Polati1/new-tracker-hardware/NewTrackerMotor/Stackup_Impedance.png

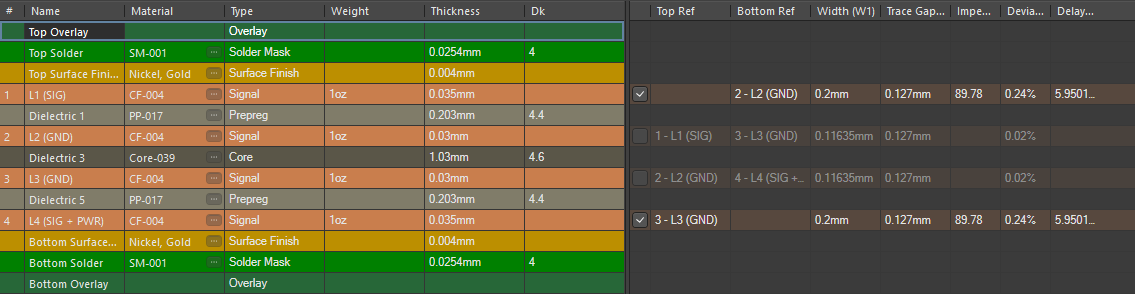
NewTrackerMotor/Stackup_Impedance.png
