Polati1/new-tracker-hardware/README.md

Schematics / PCBs / BOM / Gerber Files / Libraries / Footprints of:

1. FLO Motor Driver Control Board
2. FLO Orientation Sensing Board
3. FLO Stepper Driver Control Board
4. FLO IR Illumination Control Board
5. FLO IR Illumination LED Board
6. Additional Buck Converter Layouts
