Polati1/new-tracker-hardware/NewTrackerIR/NewTrackerIR.pdf

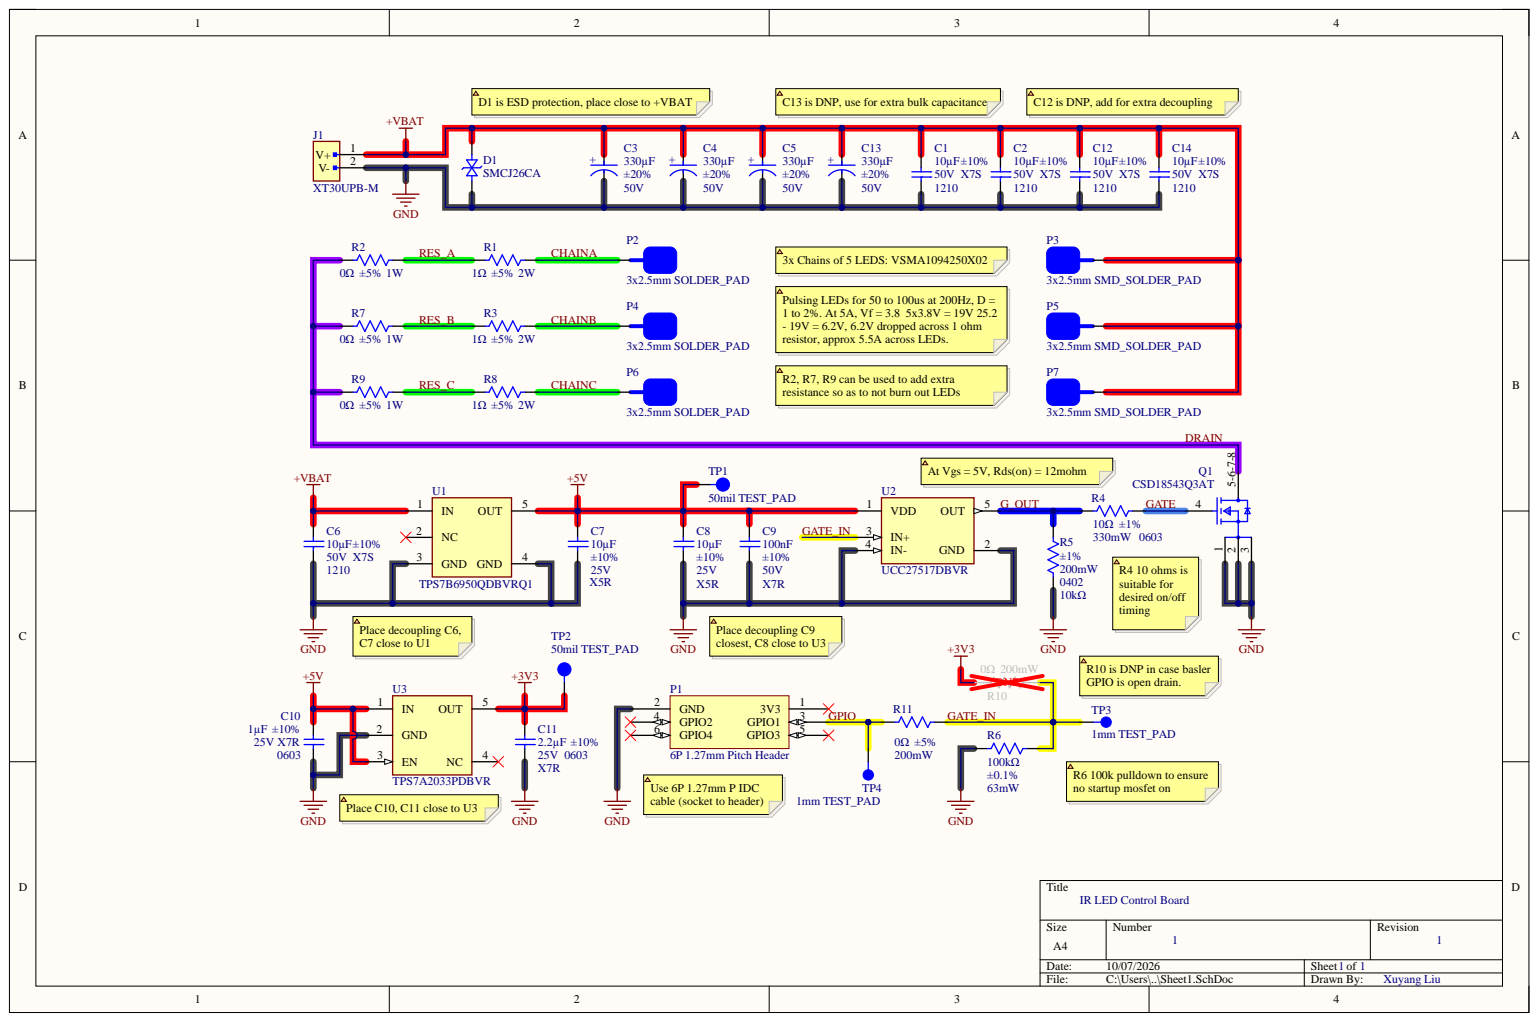
[picture p2: page 1]

Pulsing LEDs for 50 to 100us at 200Hz, D =
- 19V = 6.2V, 6.2V dropped across 1 ohm
resistor, approx 5.5A across LEDs.

R2, R7, R9 can be used to add extra
resistance so as to not burn out LEDs

At Vgs = 5V, Rds(on) = 12mohm

R10 is DNP in case basler
GPIO is open drain.

GND 2

R6 100k pulldown to ensure
no startup mosfet on

Use 6P 1.27mm P IDC
cable (socket to header)

IR LED Control Board

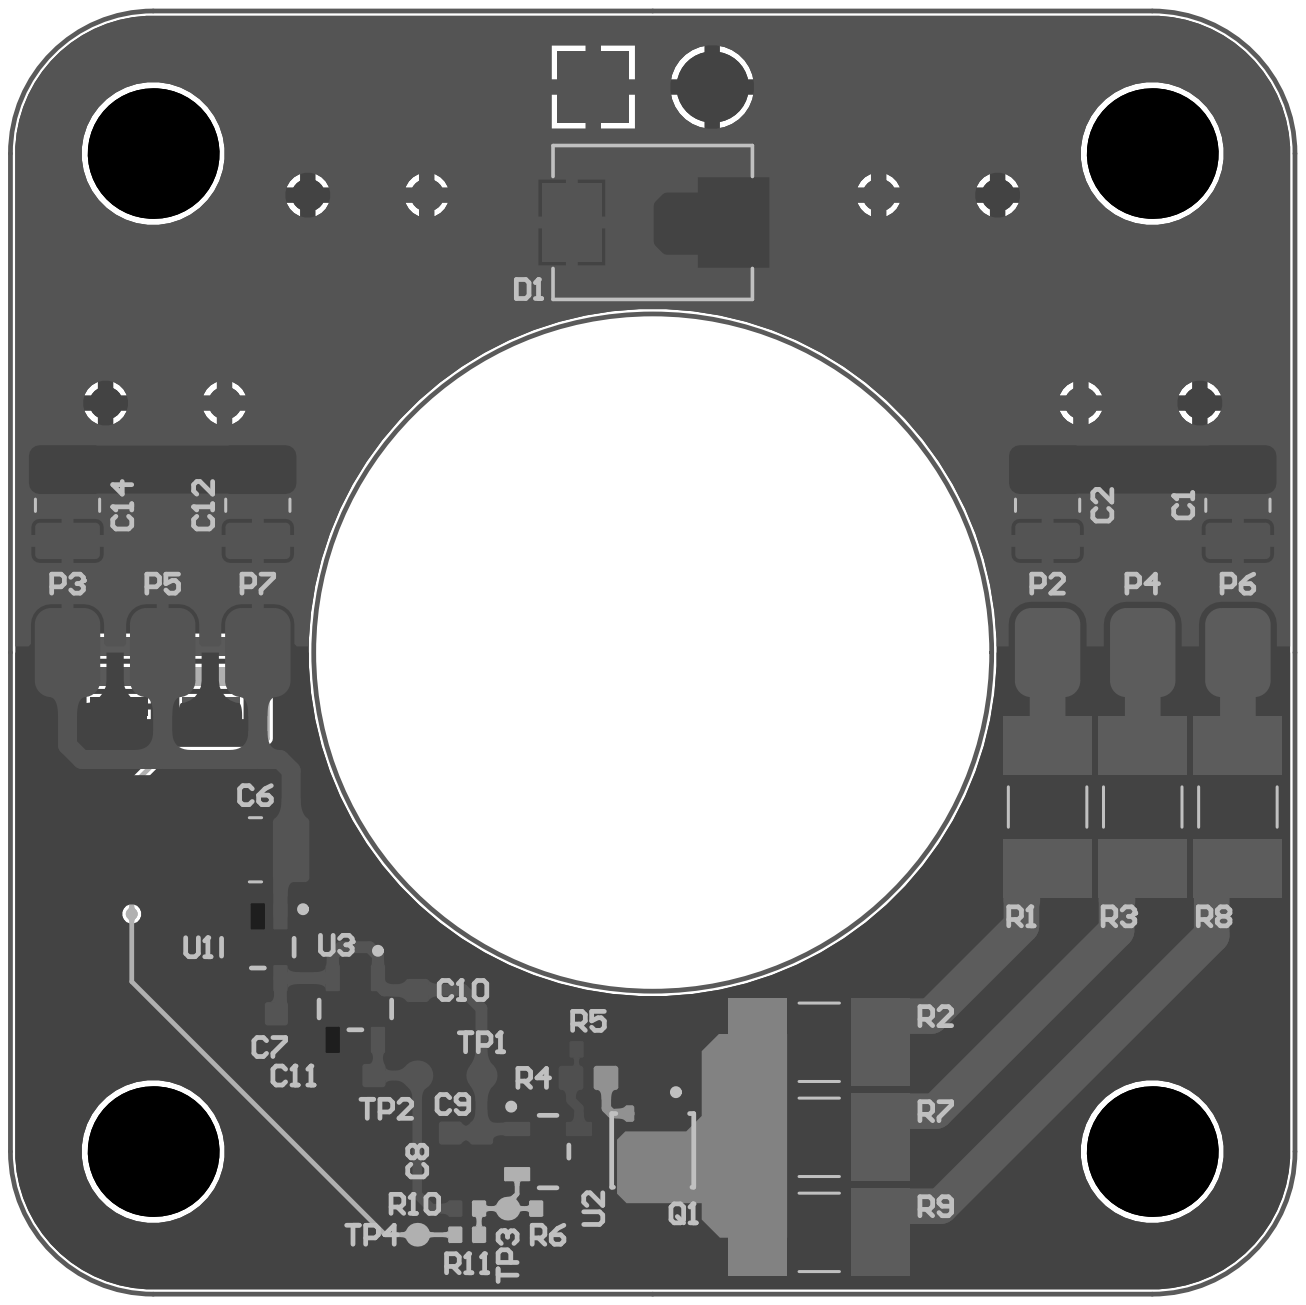
[picture p3: page 2]
