Polati1/new-tracker-hardware/NewTrackerMain/NewTrackerMain.pdf

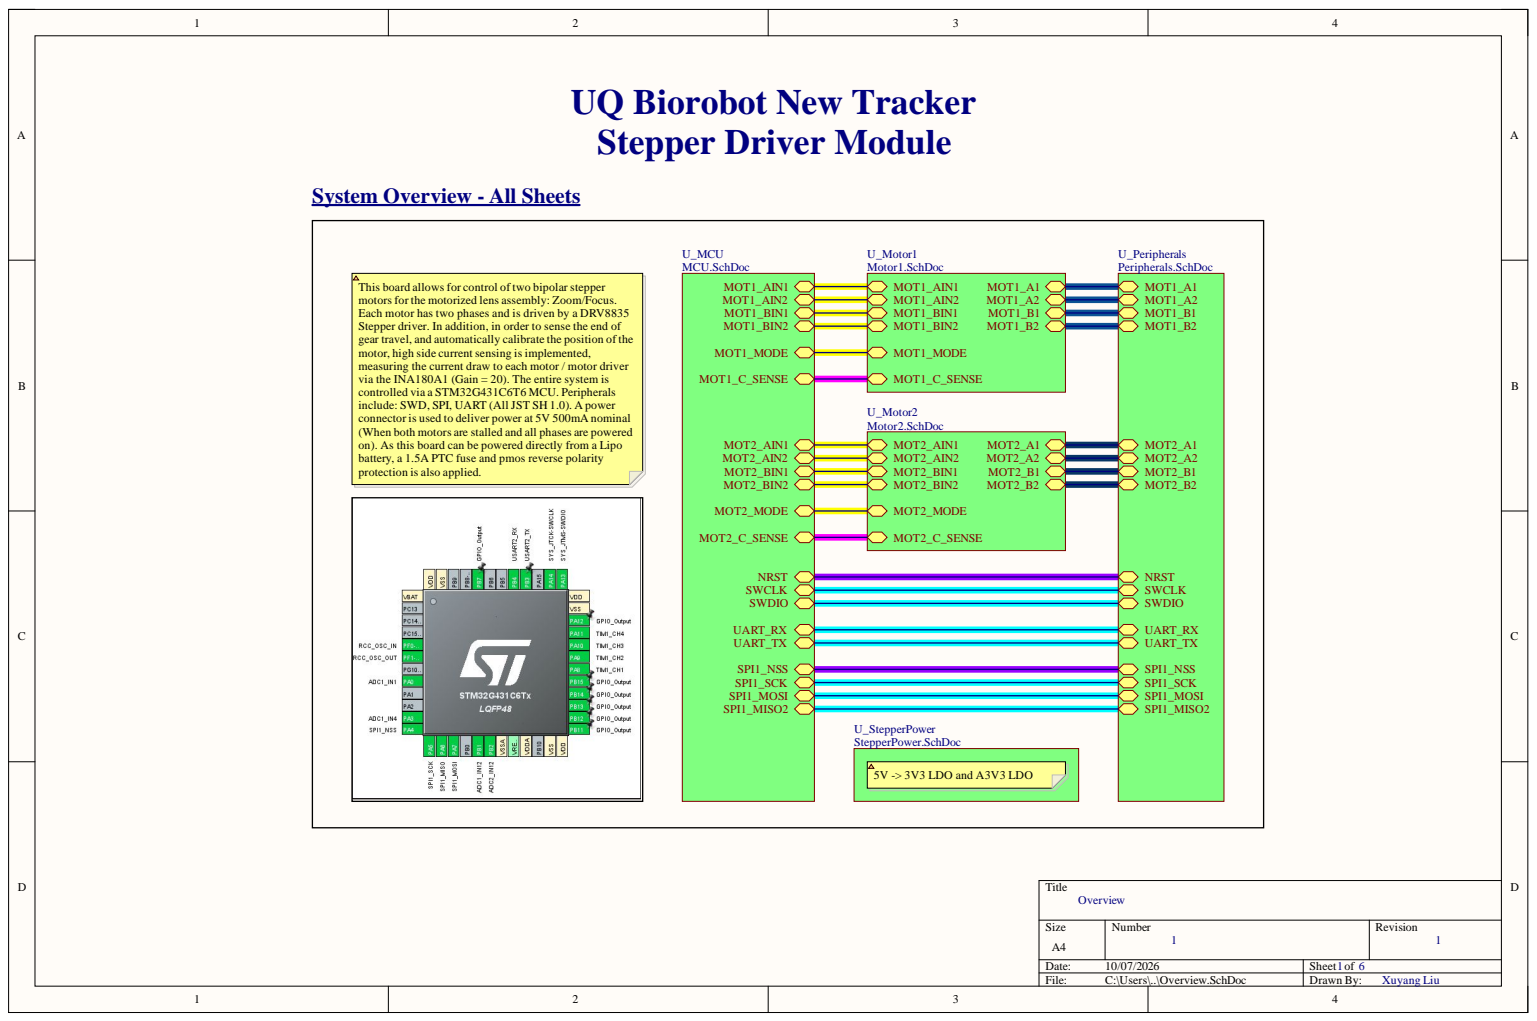
[picture p4: page 1]

UQ Biorobot New Tracker
Stepper Driver Module

System Overview - All Sheets

This board allows for control of two bipolar stepper
motors for the motorized lens assembly: Zoom/Focus.
Each motor has two phases and is driven by a DRV8835
Stepper driver. In addition, in order to sense the end of
gear travel, and automatically calibrate the position of the
motor, high side current sensing is implemented,
measuring the current draw to each motor / motor driver
via the INA180A1 (Gain = 20). The entire system is
controlled via a STM32G431C6T6 MCU. Peripherals
include: SWD, SPI, UART (All JST SH 1.0). A power
connector is used to deliver power at 5V 500mA nominal
(When both motors are stalled and all phases are powered
on). As this board can be powered directly from a Lipo
battery, a 1.5A PTC fuse and pmos reverse polarity
protection is also applied.

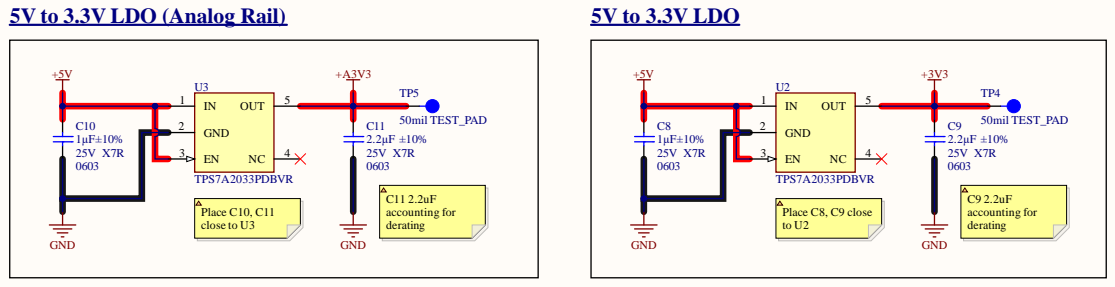
[picture p5: page 2]

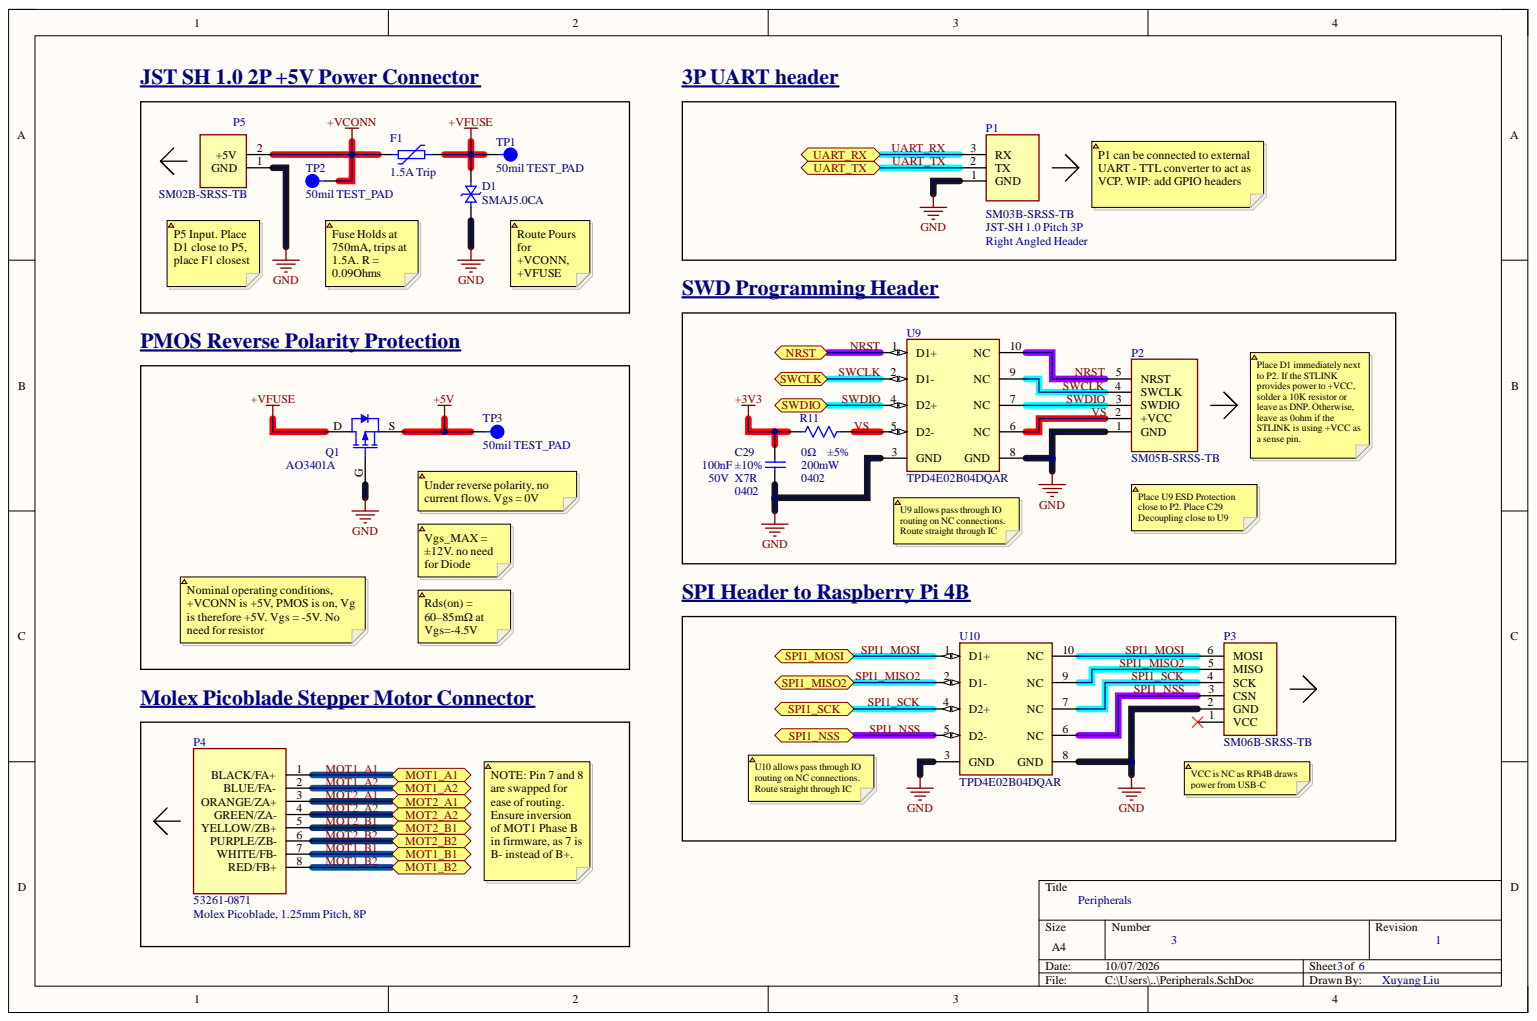
[picture p6: page 3]

JST SH 1.0 2P +5V Power Connector

P1 can be connected to external
UART - TTL converter to act as
VCP. WIP: add GPIO headers

PMOS Reverse Polarity Protection

to P2. If the STLINK
provides power to +VCC,
solder a 10K resistor or
leave as DNP. Otherwise,
leave as 0ohm if the
STLINK is using +VCC as
a sense pin.

Under reverse polarity, no
current flows. Vgs = 0V

U9 allows pass through IO
routing on NC connections.
Route straight through IC

Nominal operating conditions,
+VCONN is +5V, PMOS is on, Vg
is therefore +5V. Vgs = -5V. No
need for resistor

SPI Header to Raspberry Pi 4B

Molex Picoblade Stepper Motor Connector

U10 allows pass through IO

NOTE: Pin 7 and 8
are swapped for
ease of routing.
Ensure inversion
of MOT1 Phase B
in firmware, as 7 is
B- instead of B+.

VCC is NC as RPi4B draws
power from USB-C

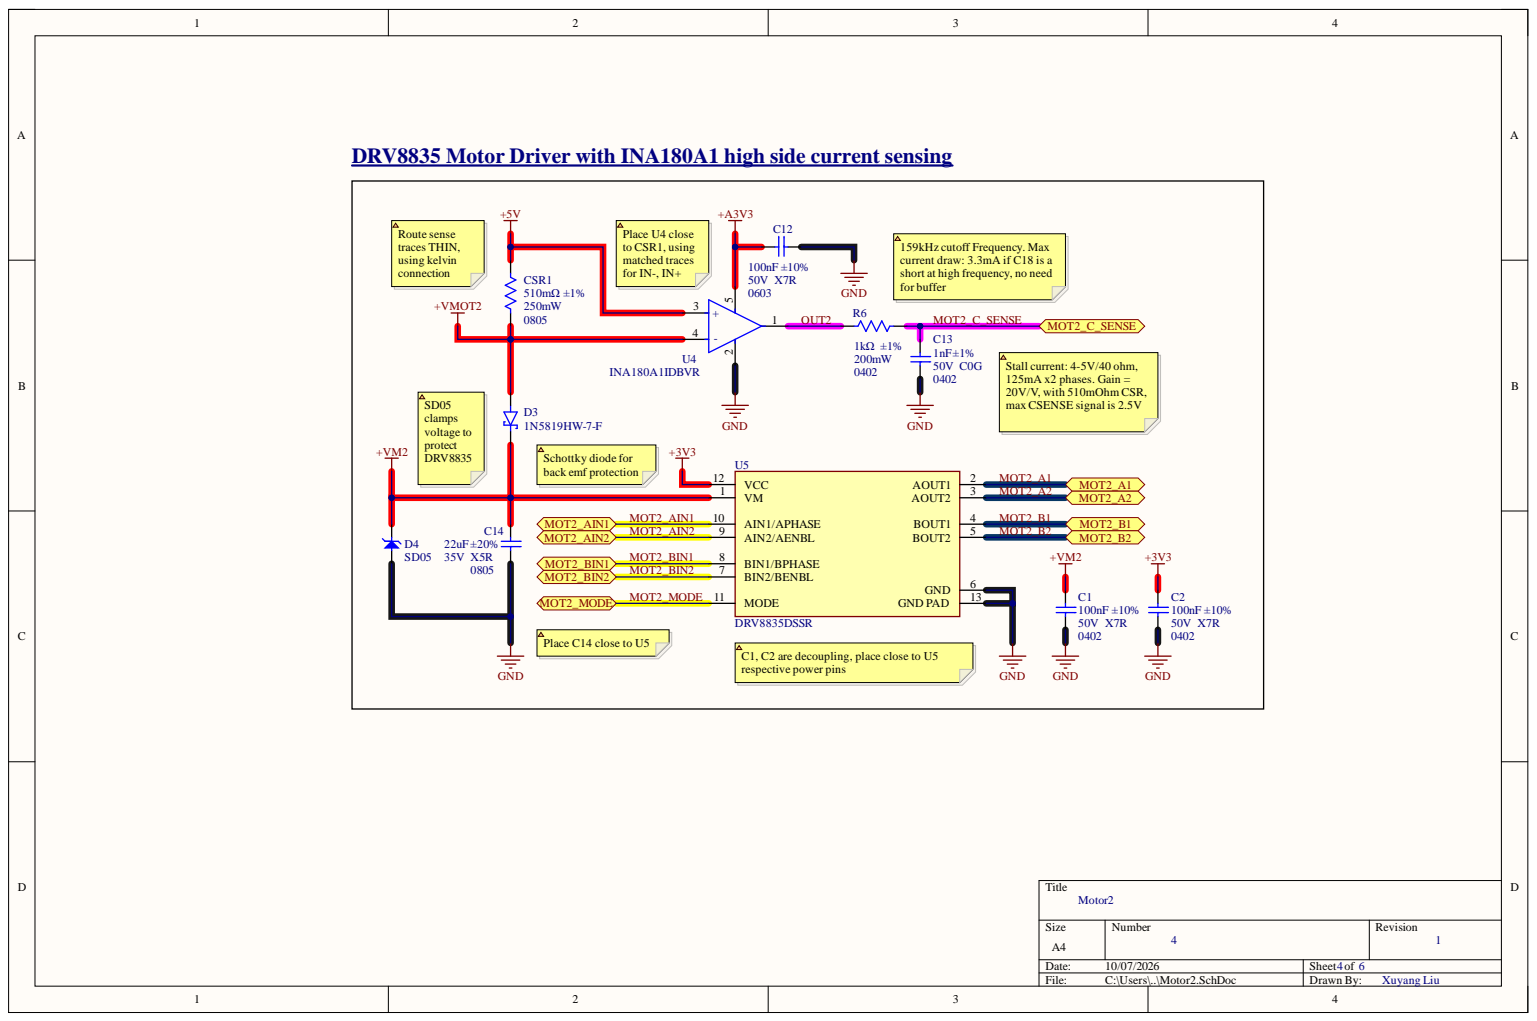
[picture p7: page 4]

DRV8835 Motor Driver with INA180A1 high side current sensing

159kHz cutoff Frequency. Max
current draw: 3.3mA if C18 is a
short at high frequency, no need
for buffer

Stall current: 4-5V/40 ohm,
125mA x2 phases. Gain =
20V/V, with 510mOhm CSR,
max CSENSE signal is 2.5V

C1, C2 are decoupling, place close to U5
respective power pins

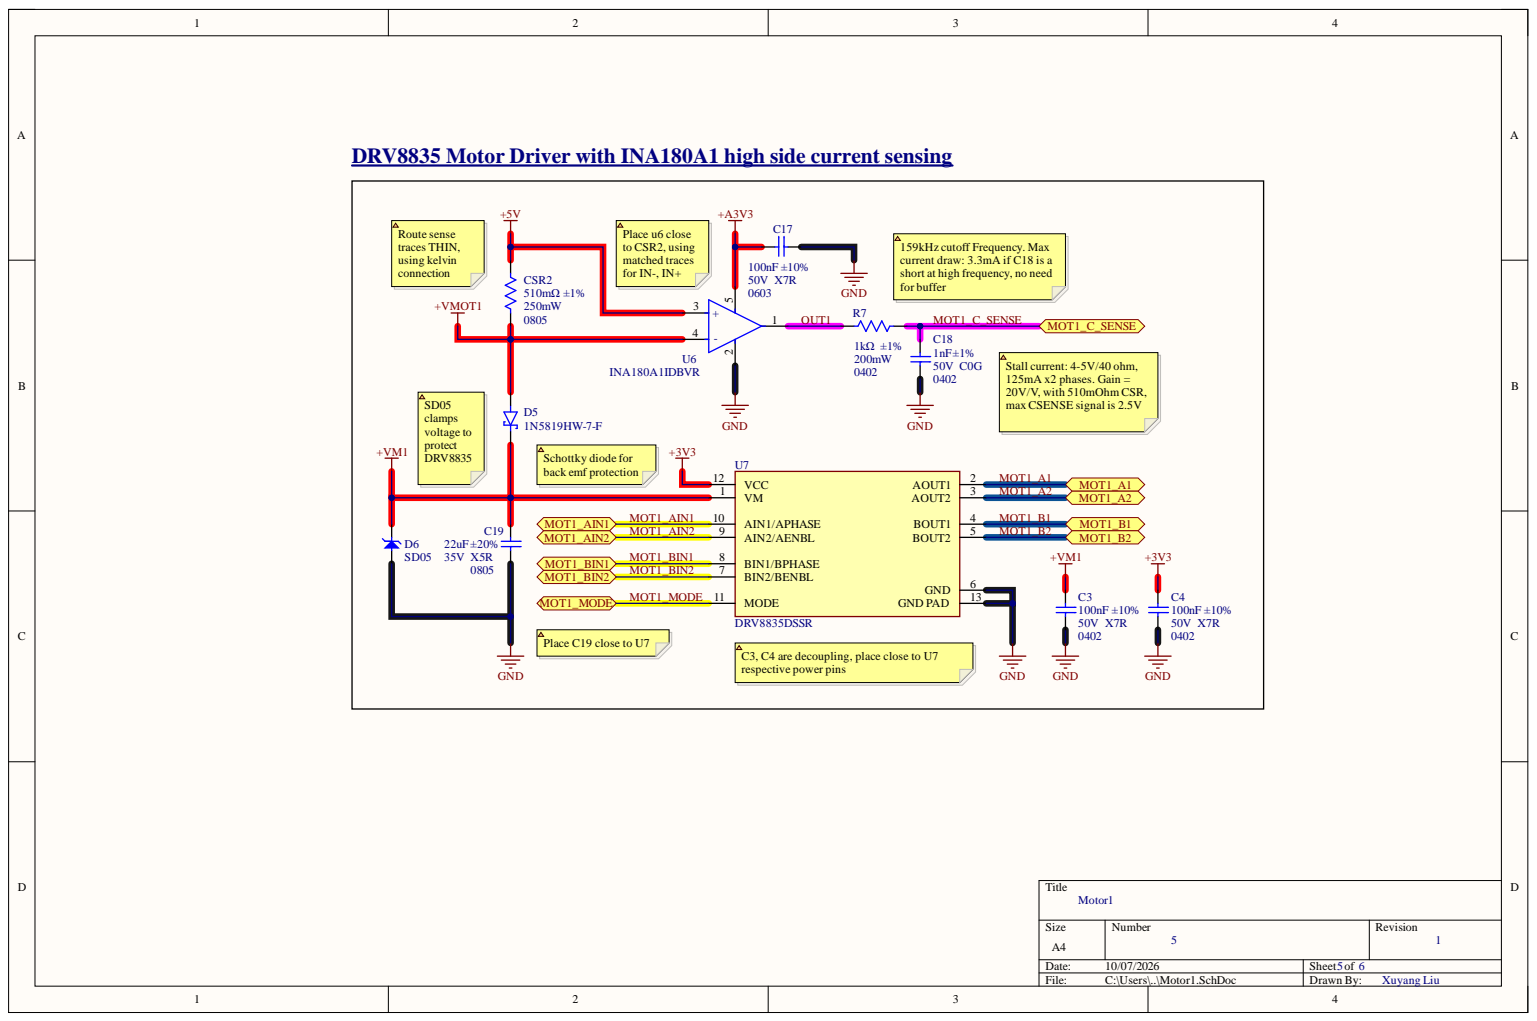
[picture p8: page 5]

DRV8835 Motor Driver with INA180A1 high side current sensing

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

C3, C4 are decoupling, place close to U7
respective power pins

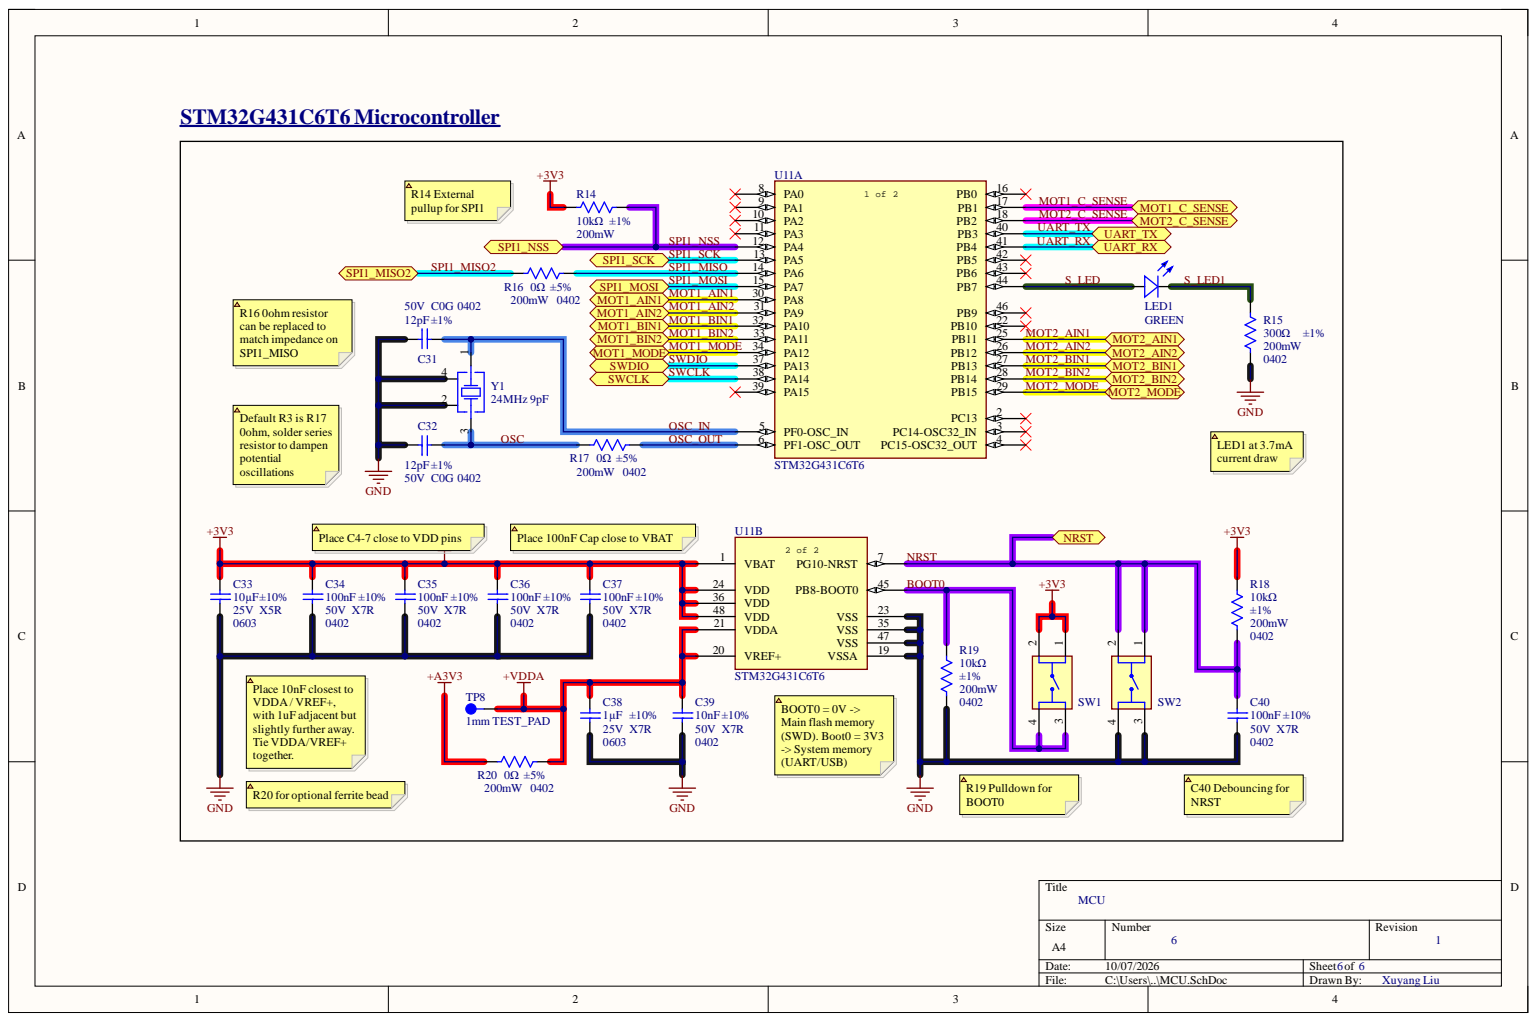
[picture p9: page 6]

R16 0ohm resistor
can be replaced to
match impedance on
SPI1_MISO

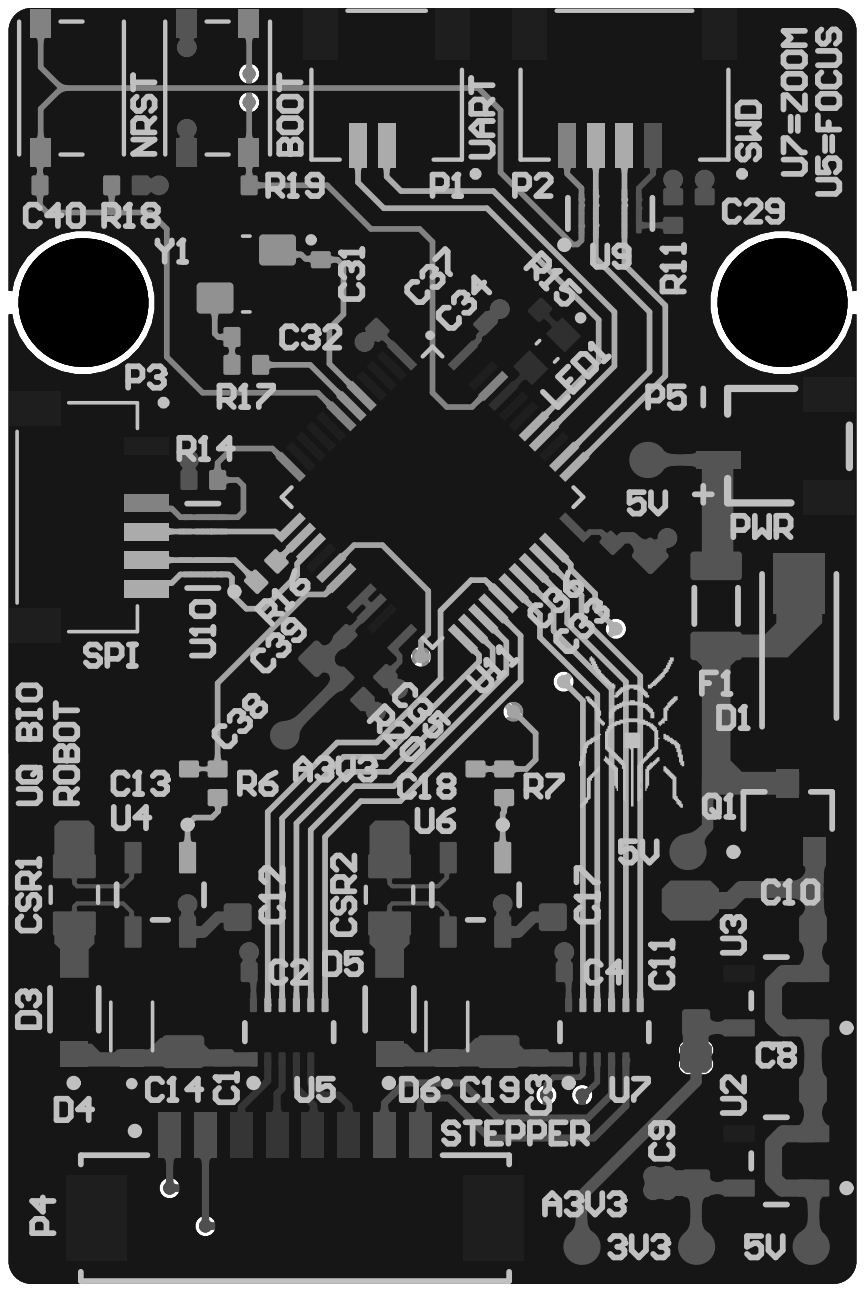
[picture p10: page 7]
