Polati1/new-tracker-hardware/NewTrackerMotor/NewTracker.pdf

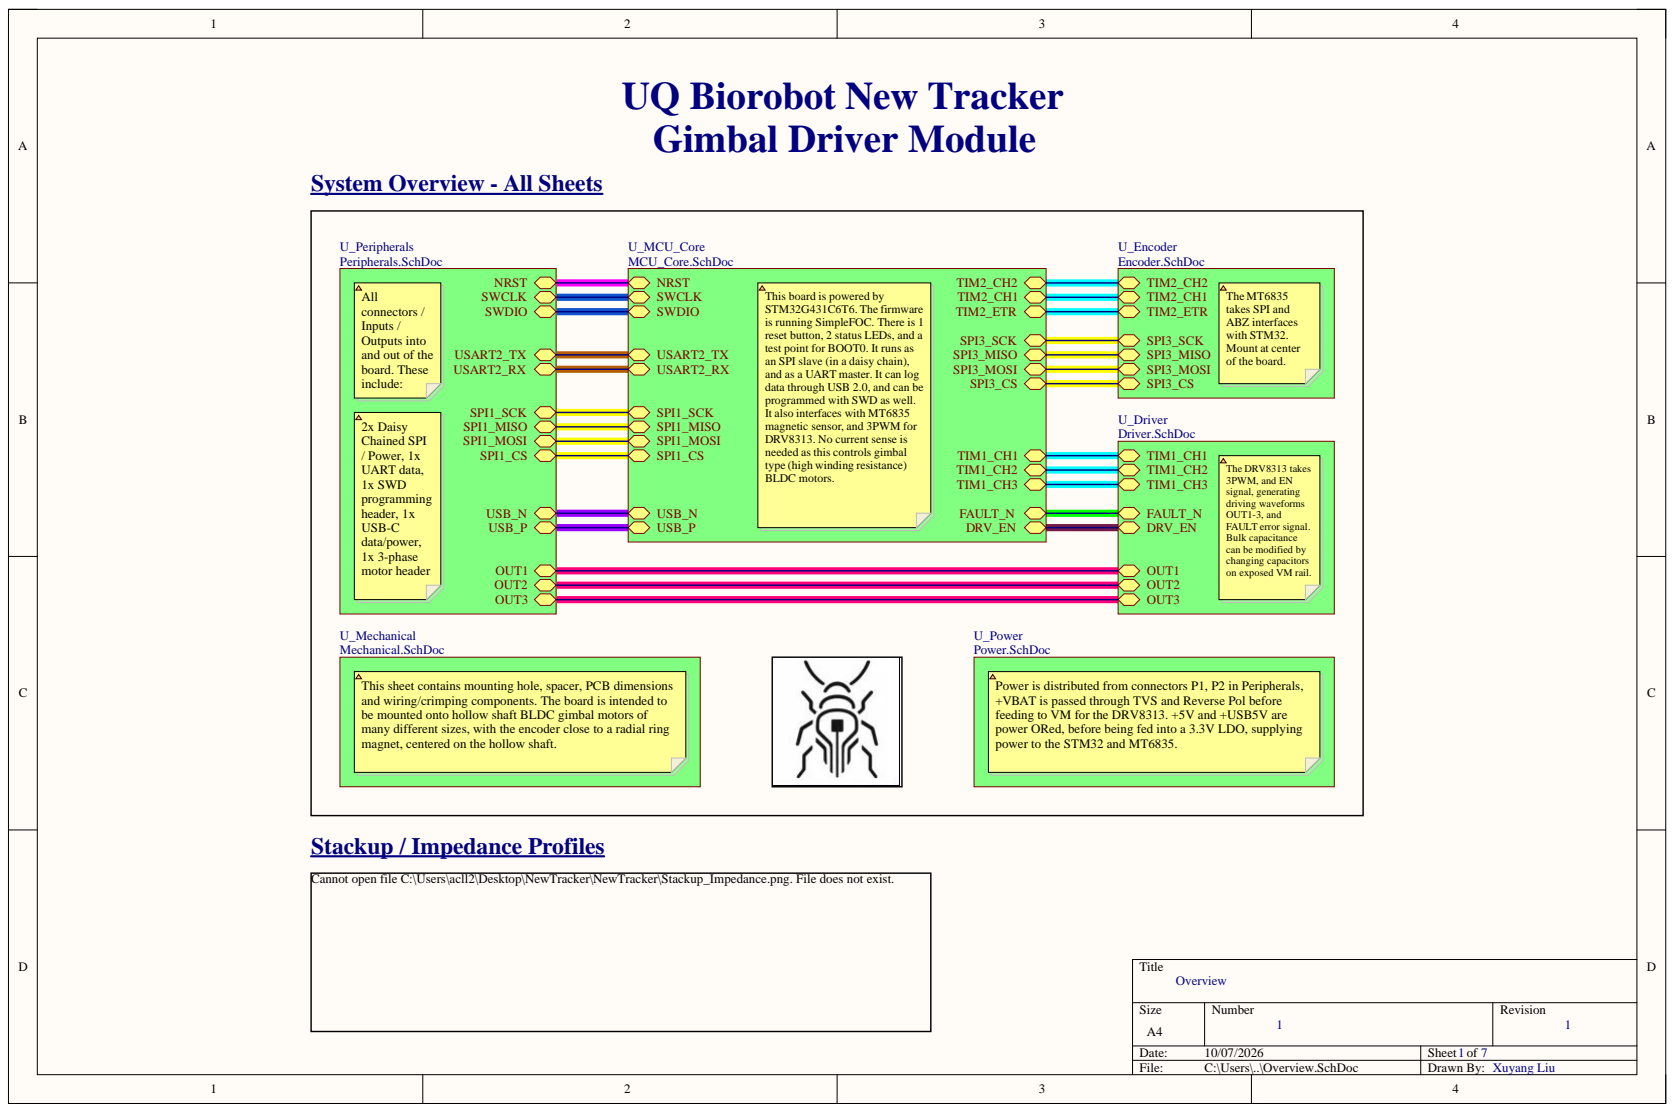
[picture p11: page 1]

UQ Biorobot New Tracker
Gimbal Driver Module

System Overview - All Sheets

This board is powered by
STM32G431C6T6. The firmware
is running SimpleFOC. There is 1
reset button, 2 status LEDs, and a
test point for BOOT0. It runs as
an SPI slave (in a daisy chain),
and as a UART master. It can log
data through USB 2.0, and can be
programmed with SWD as well.
It also interfaces with MT6835
magnetic sensor, and 3PWM for
DRV8313. No current sense is
needed as this controls gimbal
type (high winding resistance)
BLDC motors.

The DRV8313 takes
3PWM, and EN
signal, generating
driving waveforms
OUT1-3, and
FAULT error signal.
Bulk capacitance
can be modified by
changing capacitors
on exposed VM rail.

This sheet contains mounting hole, spacer, PCB dimensions
and wiring/crimping components. The board is intended to
be mounted onto hollow shaft BLDC gimbal motors of
many different sizes, with the encoder close to a radial ring
magnet, centered on the hollow shaft.

Power is distributed from connectors P1, P2 in Peripherals,
+VBAT is passed through TVS and Reverse Pol before
feeding to VM for the DRV8313. +5V and +USB5V are
power ORed, before being fed into a 3.3V LDO, supplying
power to the STM32 and MT6835.

Cannot open file C:\Users\acll2\Desktop\NewTracker\NewTracker\Stackup_Impedance.png. File does not exist.

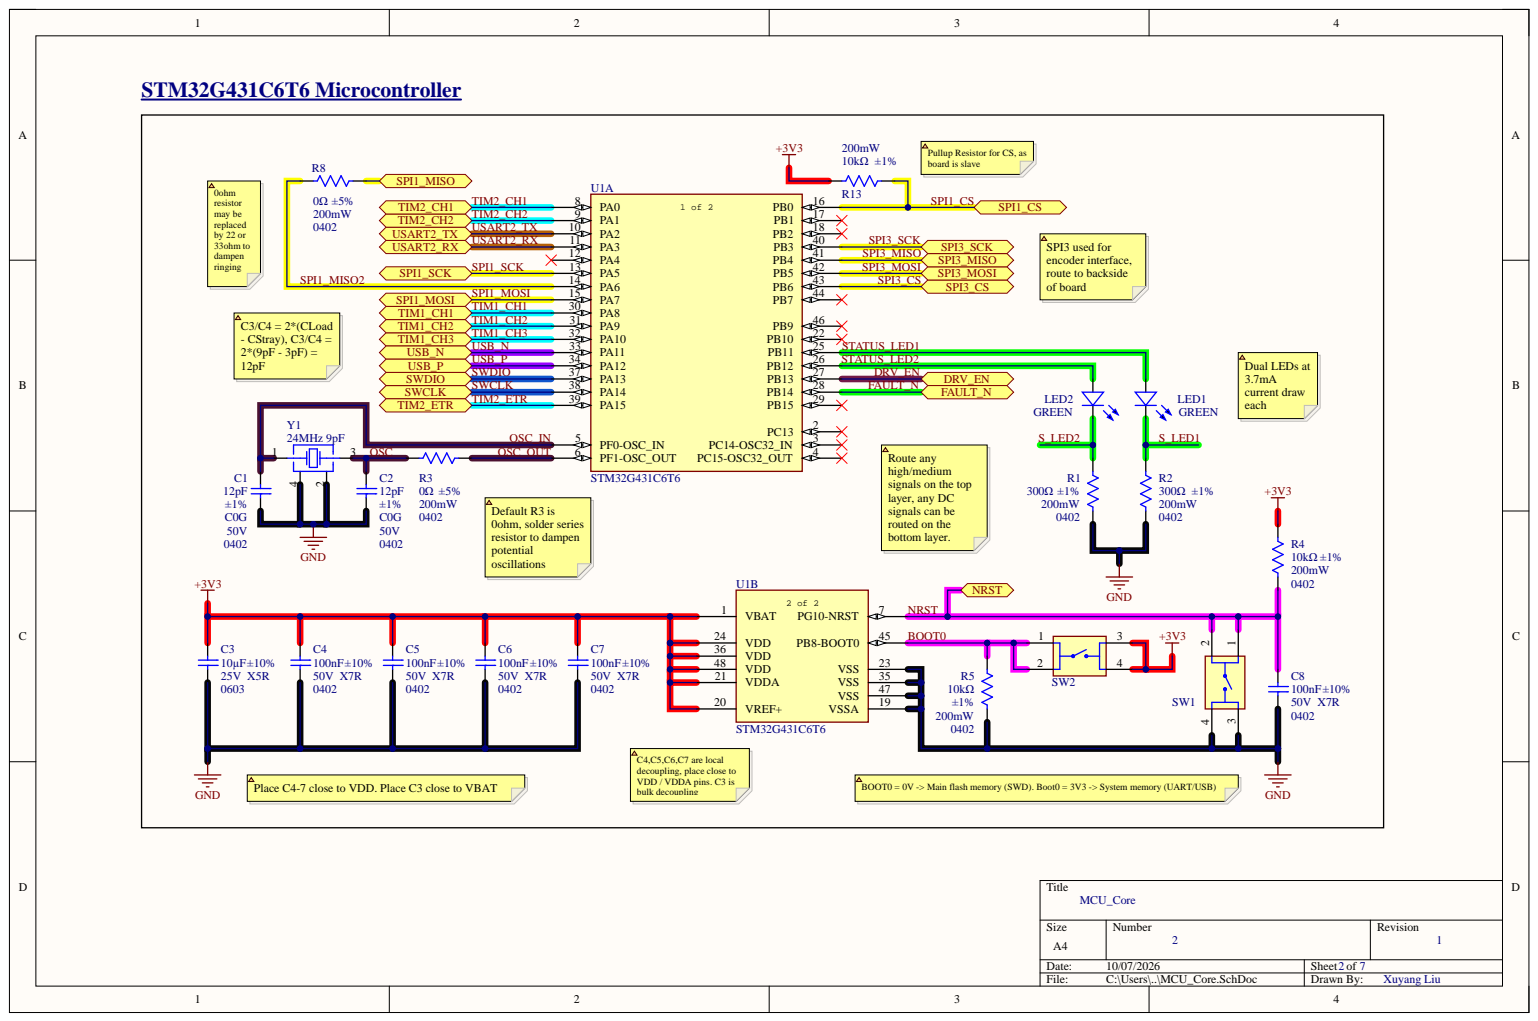
[picture p12: page 2]

p Resistor for CS, as
oard is slav

DRV_EN
FAULT_N LED2

Route any
high/medium
signals on the top
layer, any DC
signals can be
routed on the
bottom layer

VDD 24

VDD 48

C4,C5,C6,C7 are local decoupling, place close to

VDD / VDDA pins. C3 is bulk decoupling

Place C4-7 close to VDD. Place C3 close to VBA

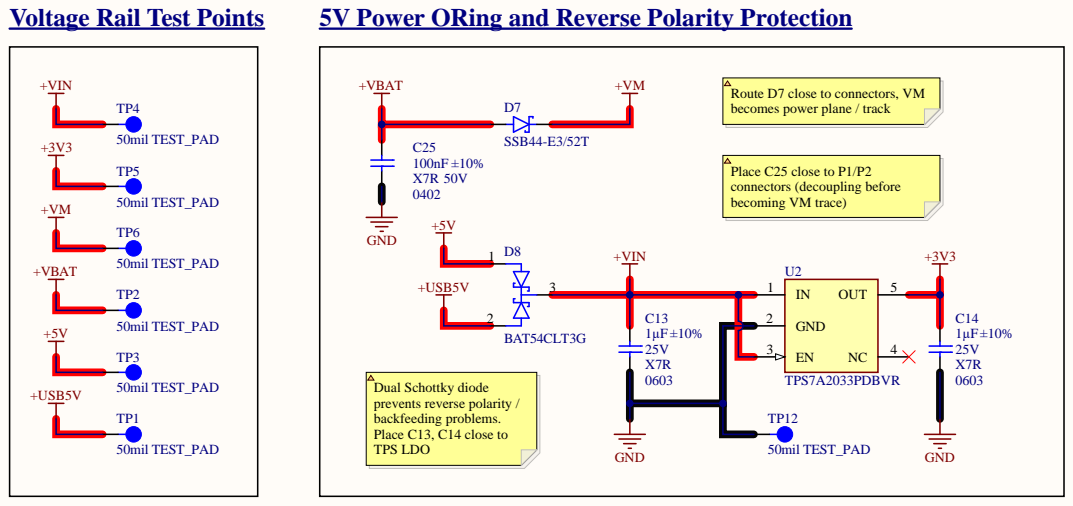
[picture p13: page 3]

Route D7 close to connectors, VM
becomes power plane / track

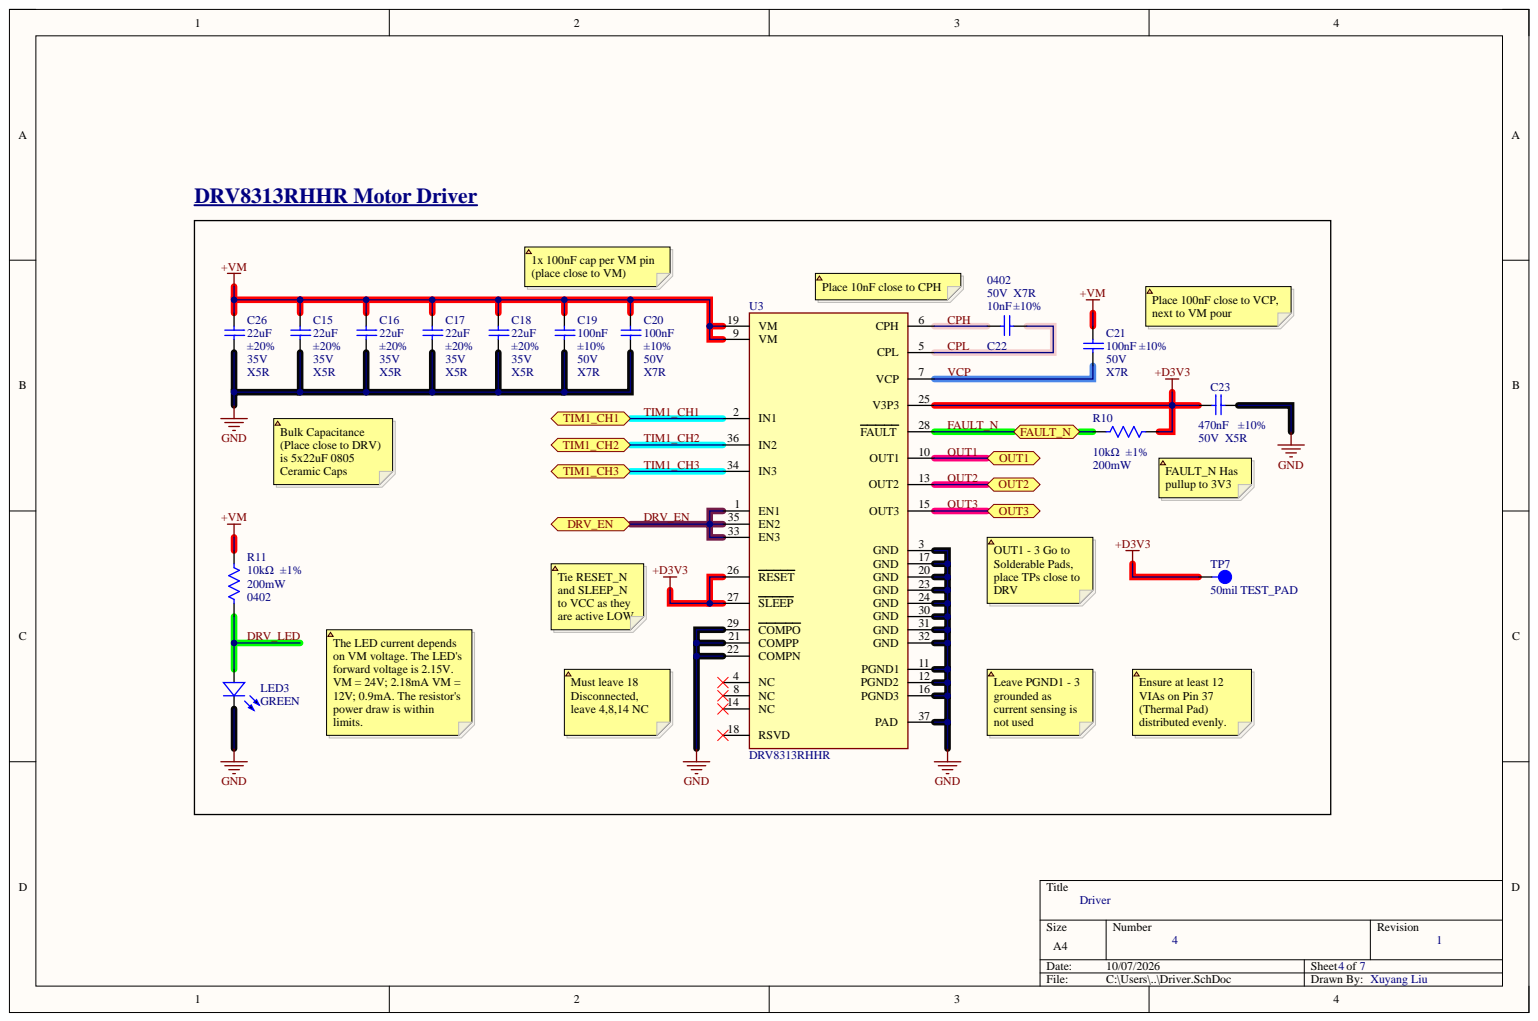
[picture p14: page 4]

1x 100nF cap per VM pin
(place close to VM)

Place 10nF close to CPH

Place 100nF close to VCP,
next to VM pour

Bulk Capacitance
(Place close to DRV)
Ceramic Caps

OUT1 - 3 Go to
Solderable Pads,
place TPs close to
DRV

Tie RESET_N
and SLEEP_N
to VCC as they
are active LOW

The LED current depends
on VM voltage. The LED'
forward voltage is 2.15V.
12V; 0.9mA. The resistor'
power draw is within
limits.

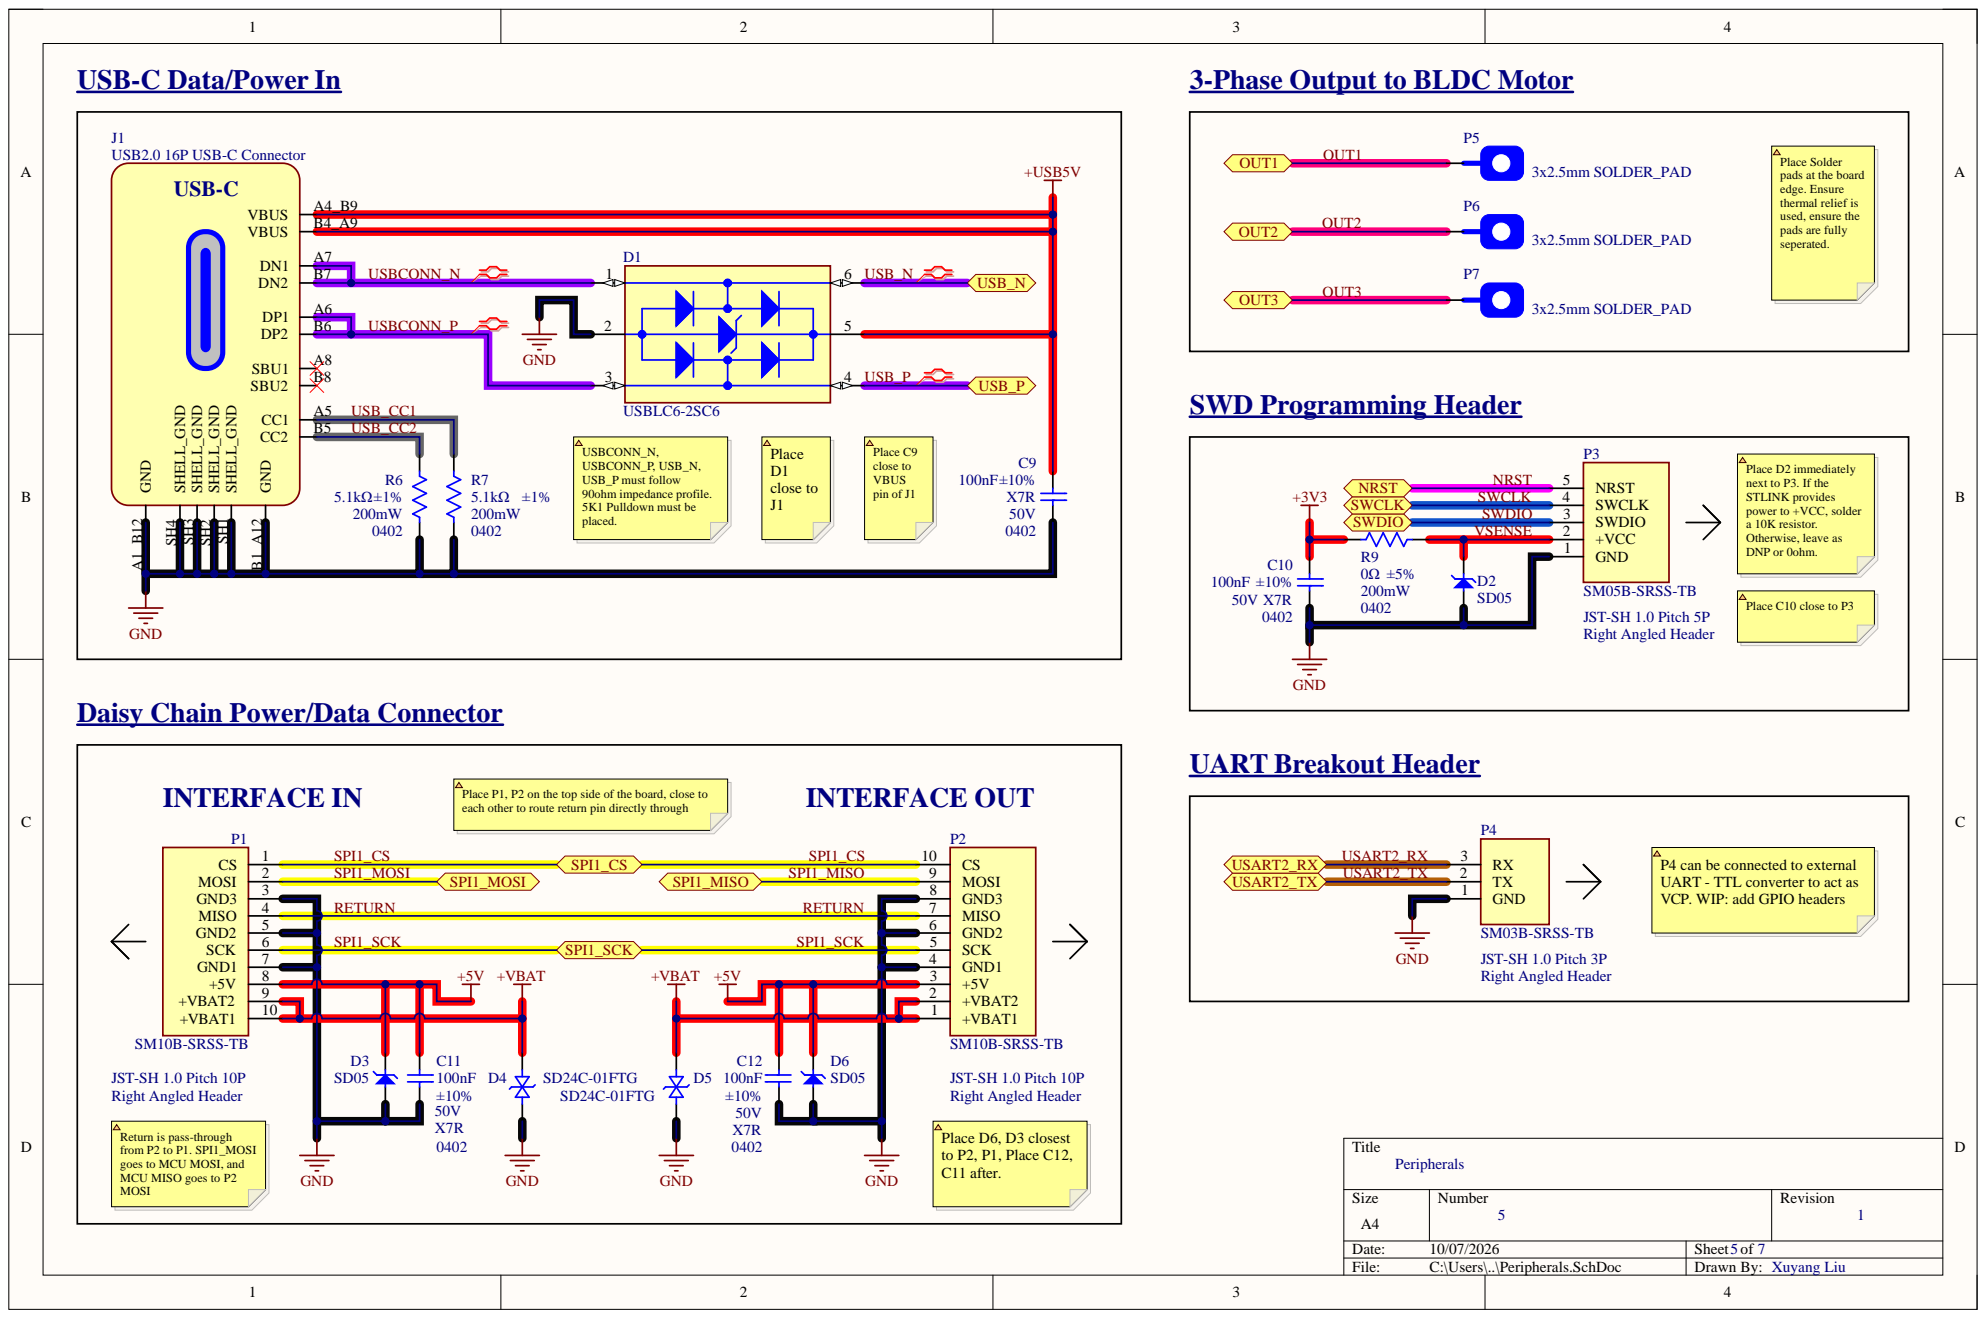
[picture p15: page 5]

USB-C Data/Power In

3-Phase Output to BLDC Motor

Place Solder
pads at the board
edge. Ensure
thermal relief is
used, ensure the
pads are fully
seperated.

Place D2 immediately
next to P3. If the
STLINK provides
power to +VCC, solder
a 10K resistor.
Otherwise, leave as
DNP or 0ohm.

Daisy Chain Power/Data Connector

Place P1, P2 on the top side of the board, close to
each other to route return pin directly through

P4 can be connected to external
UART - TTL converter to act as
VCP. WIP: add GPIO headers

Return is pass-through
from P2 to P1. SPI1_MOSI
goes to MCU MOSI, and
MCU MISO goes to P2
MOSI

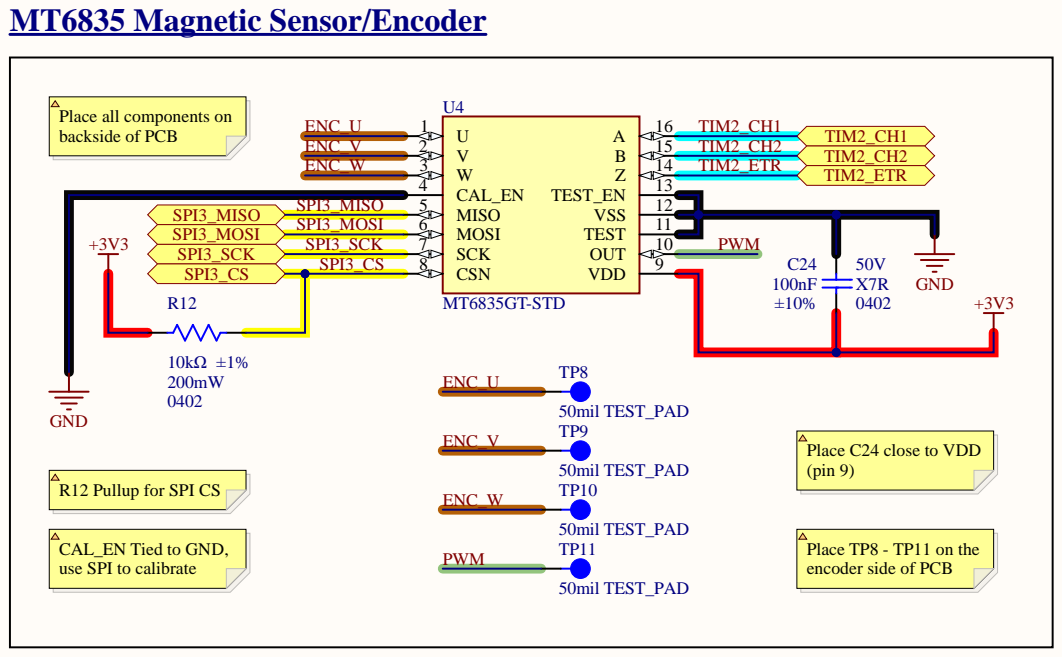
[picture p16: page 6]

Place all components on
backside of PCB

SPI3_MISO SPI3_MISO SPI3_MOSI SPI3_MOSI +3V3 SPI3_SCK 10kΩ ±1% | MISO 5 MOSI 6 SCK 7

PWM C24 | 50V X7R GND 0402

Place C24 close to VDD
(pin 9)

R12 Pullup for SPI CS

CAL_EN Tied to GND,
use SPI to calibrate

Place TP8 - TP11 on the
encoder side of PCB

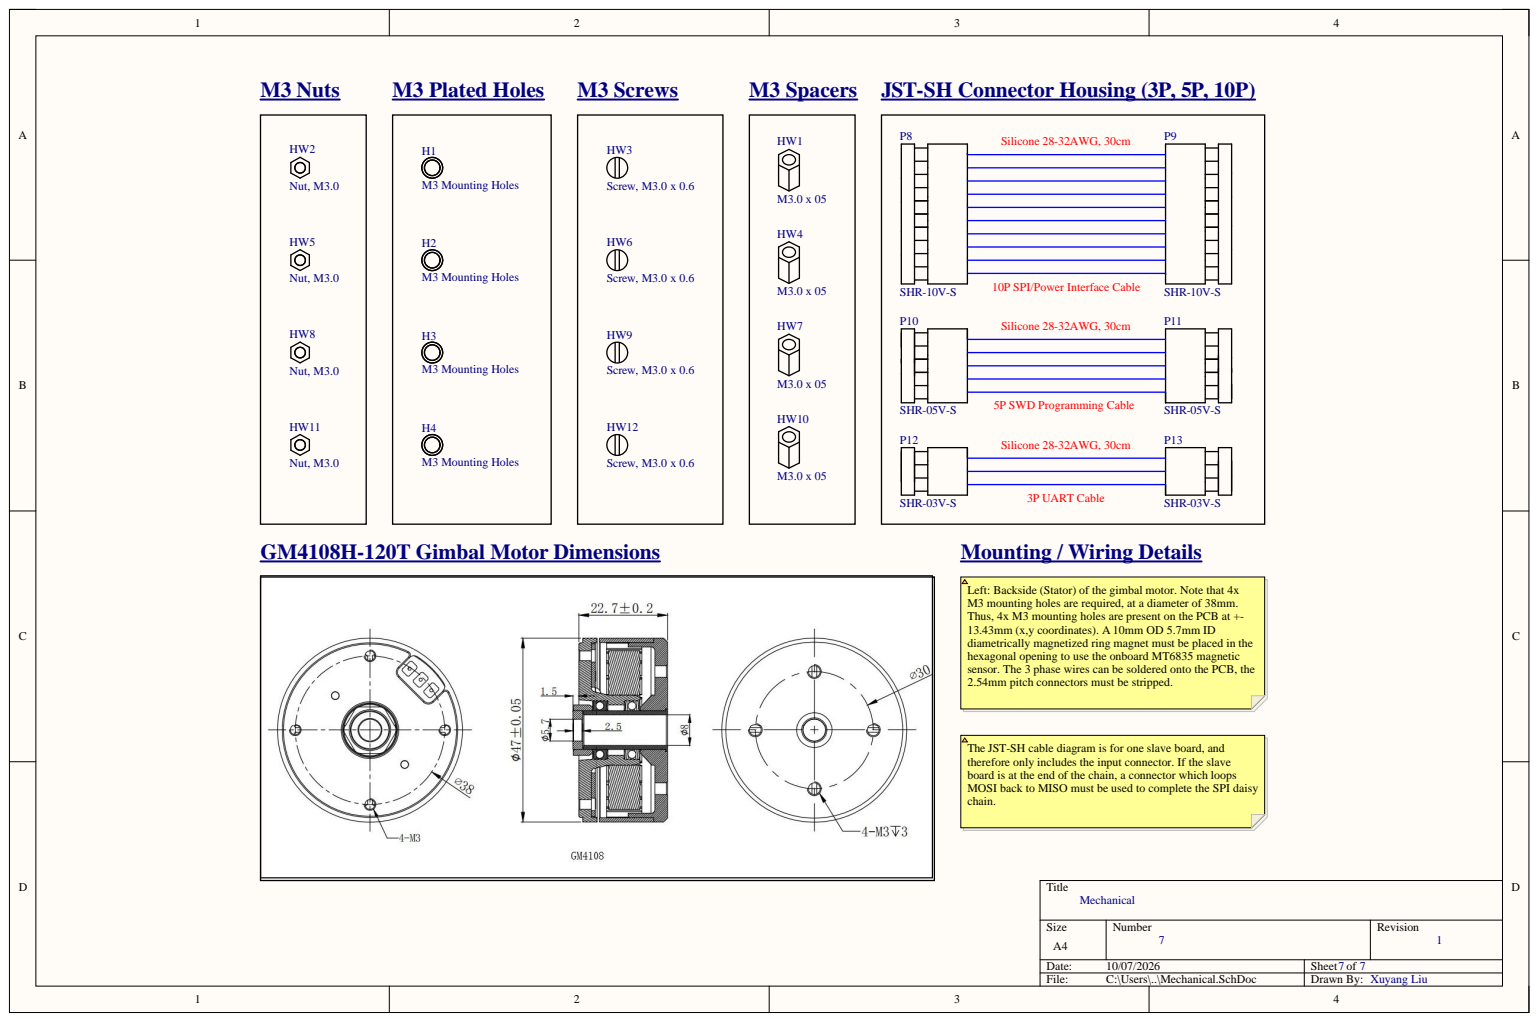
[picture p17: page 7]

10P SPI/Power Interface Cable

Left: Backside (Stator) of the gimbal motor. Note that 4x
M3 mounting holes are required, at a diameter of 38mm.
Thus, 4x M3 mounting holes are present on the PCB at +-
13.43mm (x,y coordinates).
diametrically magnetized ring magnet must be placed in the
hexagonal opening to use the onboard MT6835 magnetic
sensor. The 3 phase wires can be soldered onto the PCB, the
2.54mm pitch connectors must be stripped.

The JST-SH cable diagram is for one slave board, and
therefore only includes the input connector. If the slave
board is at the end of the chain, a connector which loops
MOSI back to MISO must be used to complete the SPI daisy
chain.

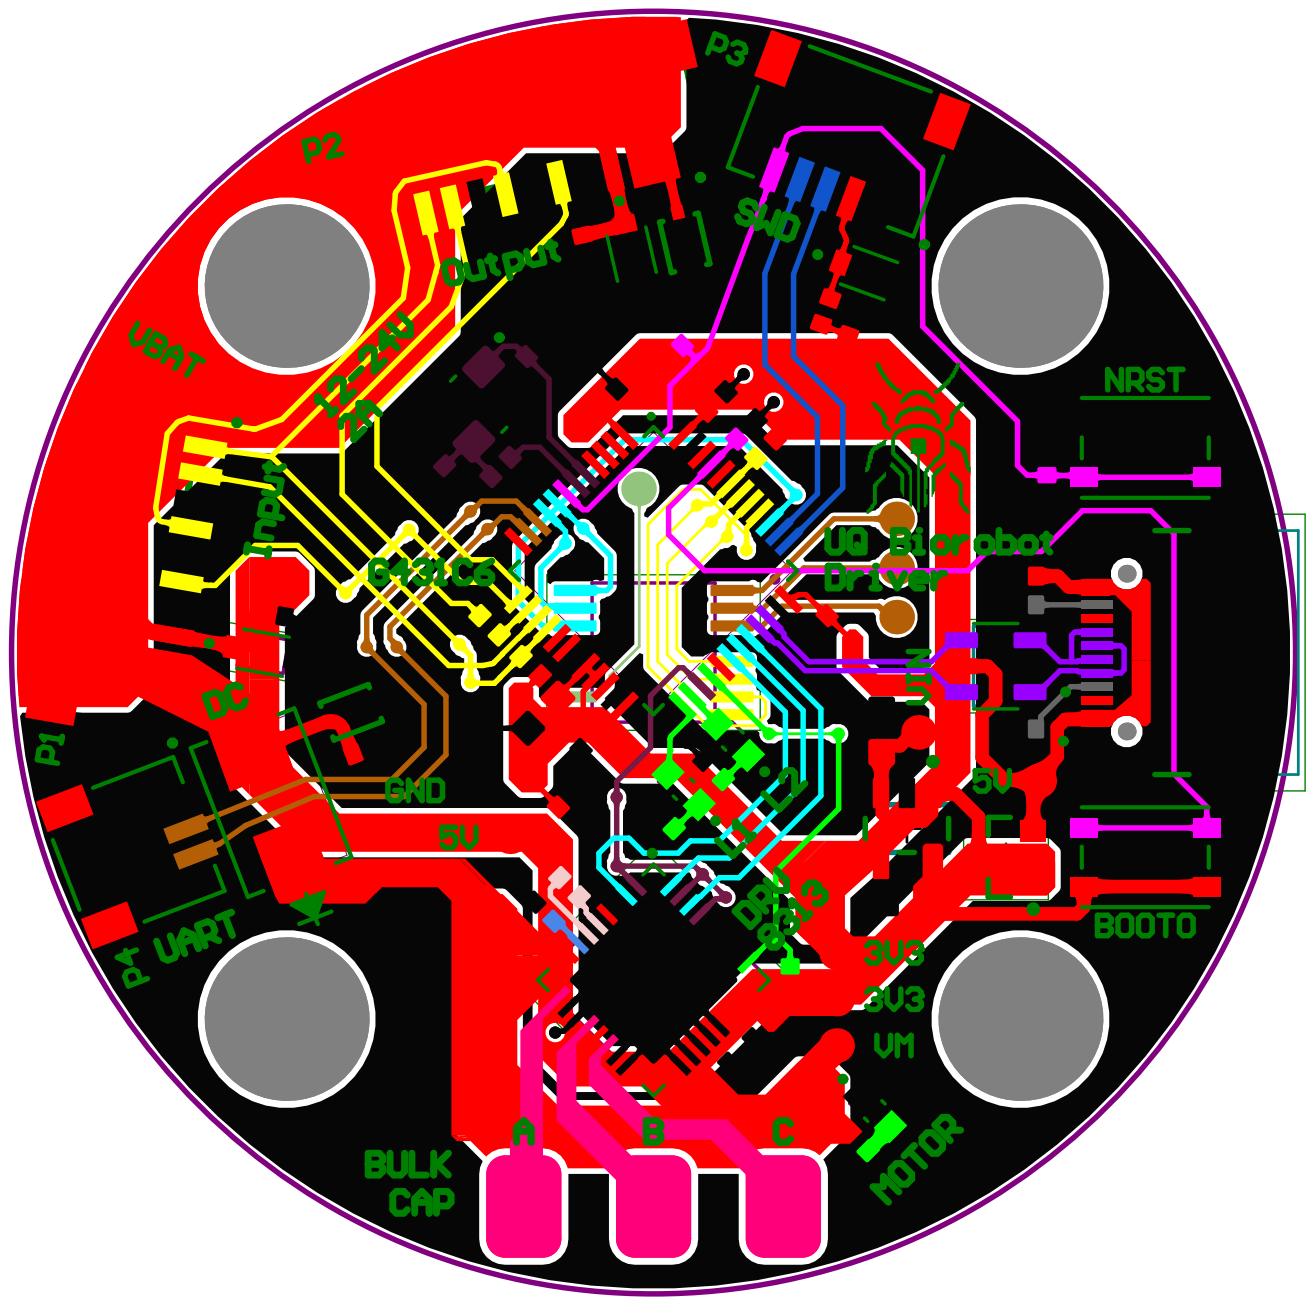
[picture p18: page 8]
