Polati1/new-tracker-hardware/NewTrackerSense/NewTrackerSense.pdf

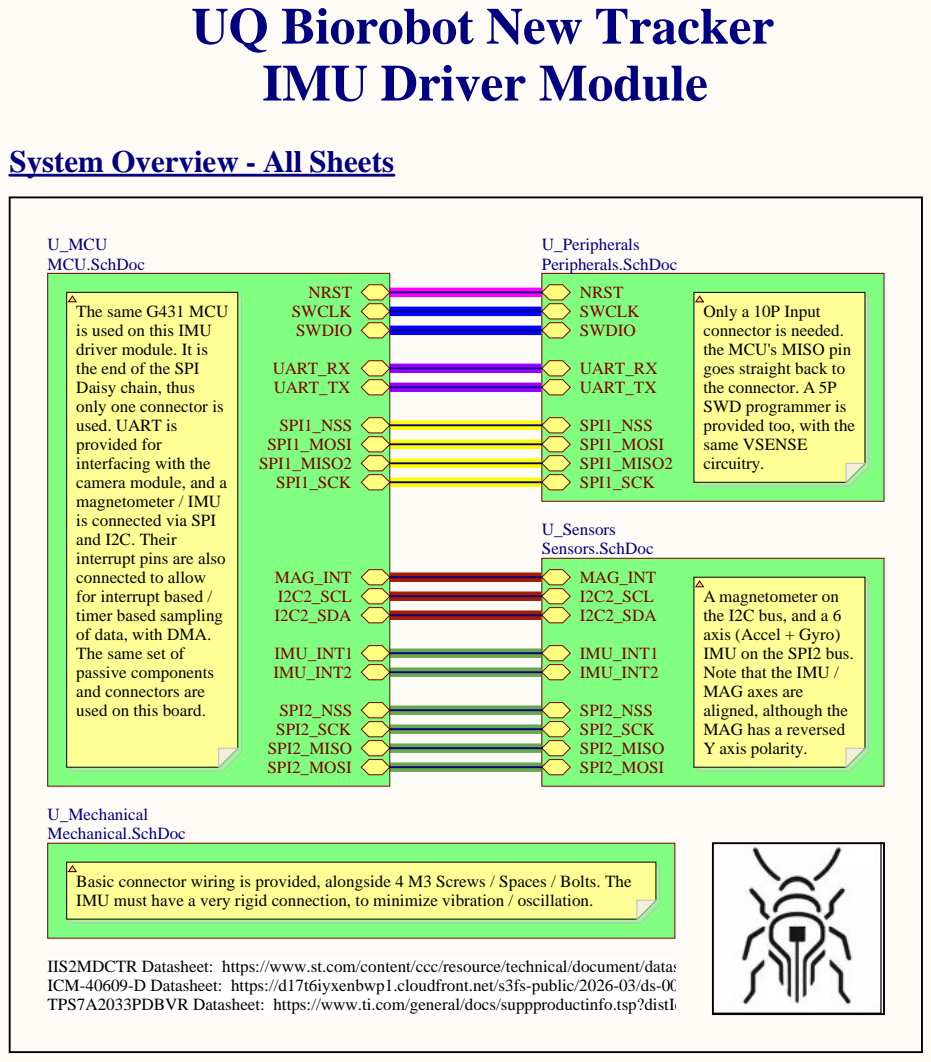
[picture p19: page 1]

UQ Biorobot New Tracker
IMU Driver Module

System Overview - All Sheets

The same G431 MCU
is used on this IMU
driver module. It is
the end of the SPI
Daisy chain, thus
only one connector is
used. UART is
provided for
interfacing with the
camera module, and a
magnetometer / IMU
is connected via SPI
and I2C. Their
interrupt pins are also
connected to allow
for interrupt based /
timer based sampling
of data, with DMA.
The same set of
passive components
and connectors are
used on this board.

Only a 10P Input
connector is needed.
the MCU's MISO pin
goes straight back to
the connector. A 5P
SWD programmer is
provided too, with the
same VSENSE
circuitry.

A magnetometer on
the I2C bus, and a 6
axis (Accel + Gyro)
IMU on the SPI2 bus.
Note that the IMU /
MAG axes are
aligned, although the
MAG has a reversed
Y axis polarity.

Basic connector wiring is provided, alongside 4 M3 Screws / Spaces / Bolts. The
IMU must have a very rigid connection, to minimize vibration / oscillation.

IIS2MDCTR Datasheet: https://www.st.com/content/ccc/resource/technical/document/datasheet/group3/06/f2/a3/a7/74/fe/4b/16/DM00431721/files/DM00431721.pdf/jcr:content/translations/en.DM004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
ICM-40609-D Datasheet: https://d17t6iyxenbwp1.cloudfront.net/s3fs-public/2026-03/ds-000330-icm-40609-d-datasheet.pdf?V
TPS7A2033PDBVR Datasheet: https://www.ti.com/general/docs/suppproductinfo.tsp?distId=10&gotoUrl=http%3A%2F%2Fwww

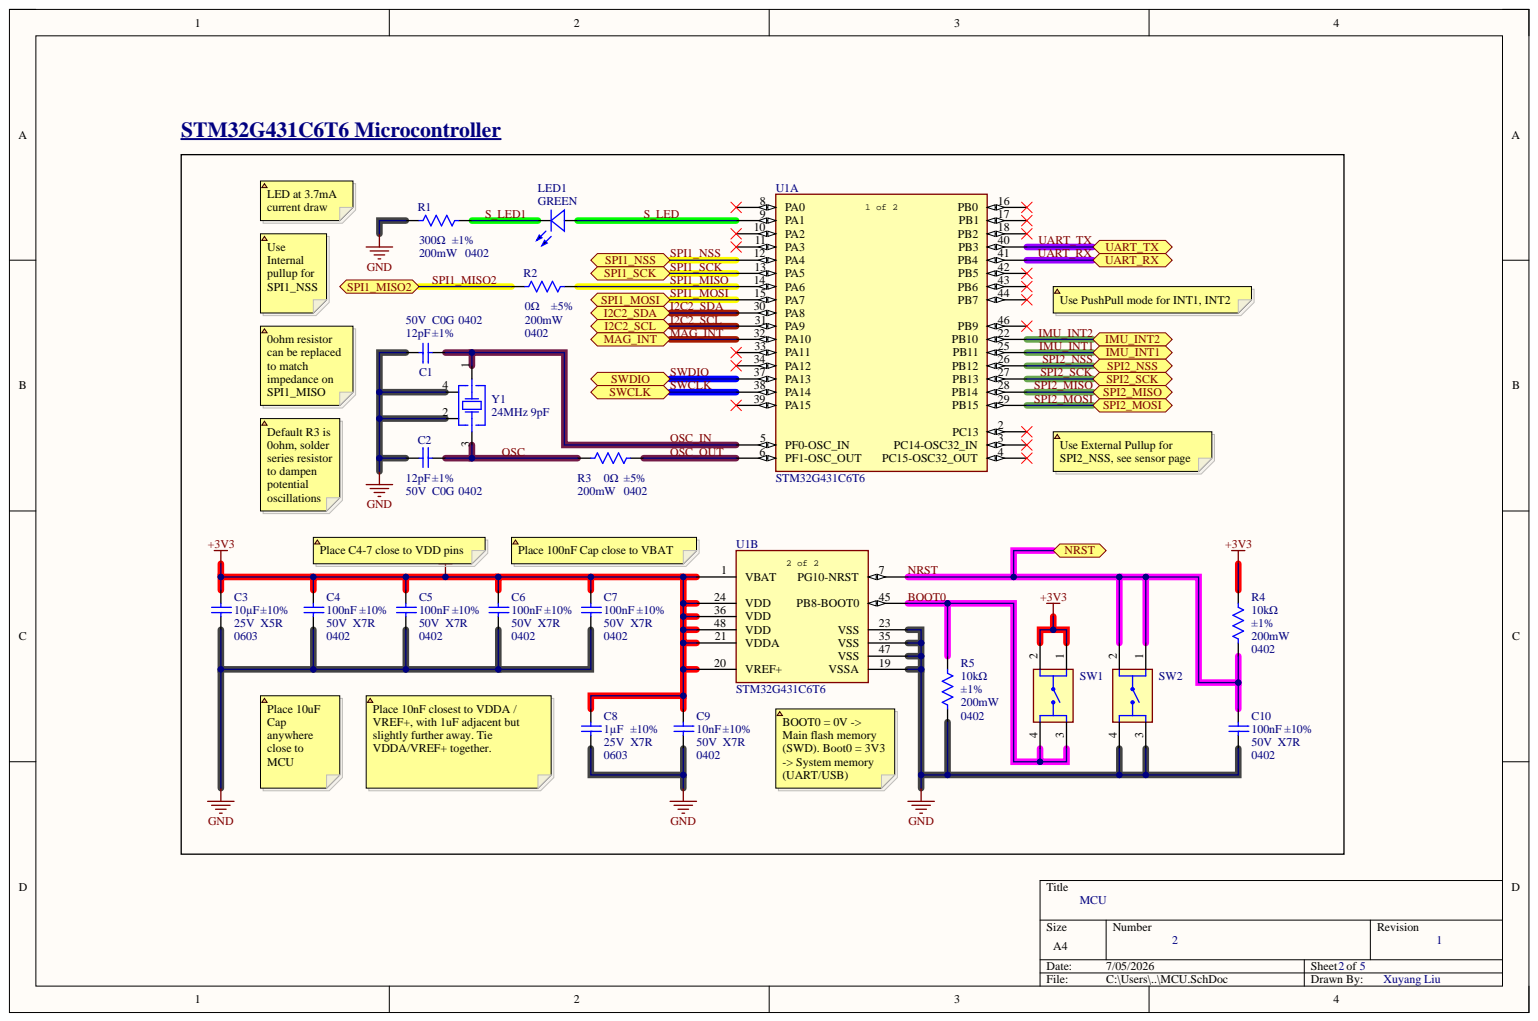
[picture p20: page 2]

Use PushPull mode for INT1, INT2

Use External Pullup for
SPI2_NSS, see sensor page

Place C4-7 close to VDD pins

Place 100nF Cap close to VBAT

Place 10nF closest to VDDA /
VREF+, with 1uF adjacent but
slightly further away. Tie
VDDA/VREF+ together.

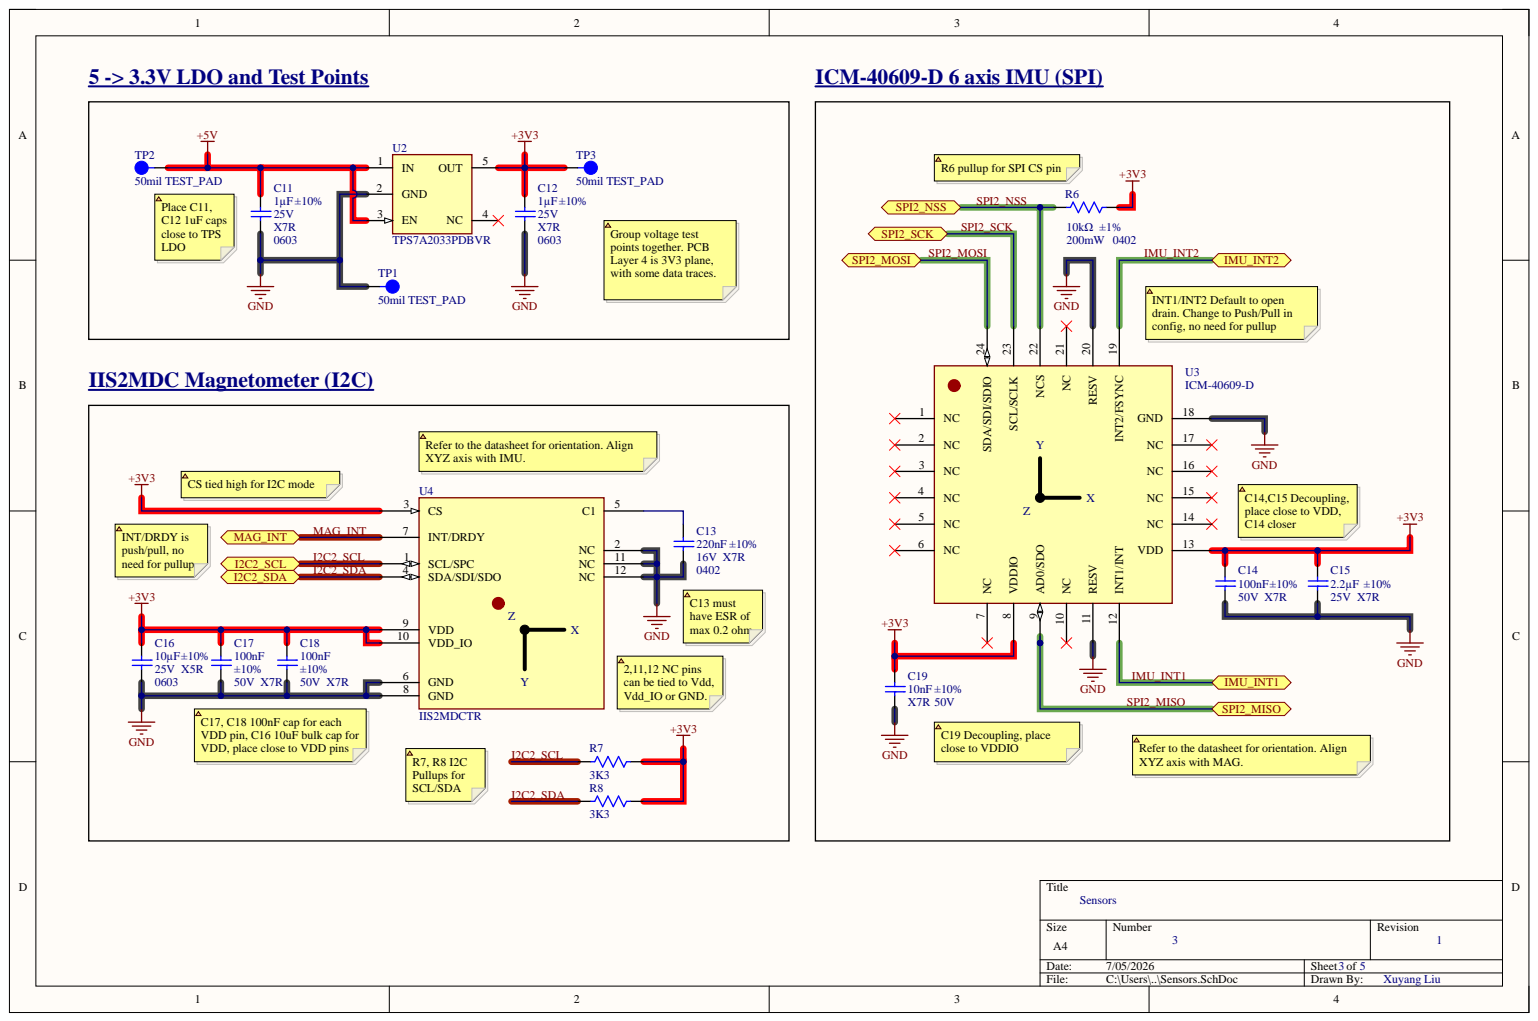
[picture p21: page 3]

5 -> 3.3V LDO and Test Points

ICM-40609-D 6 axis IMU (SPI)

R6 pullup for SPI CS pin

C11 | GND 2

X7R 0603 | EN 3 | GND

Group voltage test
points together. PCB
Layer 4 is 3V3 plane,
with some data traces.

INT1/INT2 Default to open
drain. Change to Push/Pull in
config, no need for pullup

Refer to the datasheet for orientation. Align
XYZ axis with IMU.

CS tied high for I2C mode

C14,C15 Decoupling,
place close to VDD,
C14 closer

2,11,12 NC pins
can be tied to Vdd,
Vdd_IO or GND.

C17, C18 100nF cap for each
VDD pin, C16 10uF bulk cap for
VDD, place close to VDD pins

XYZ axis with MAG.

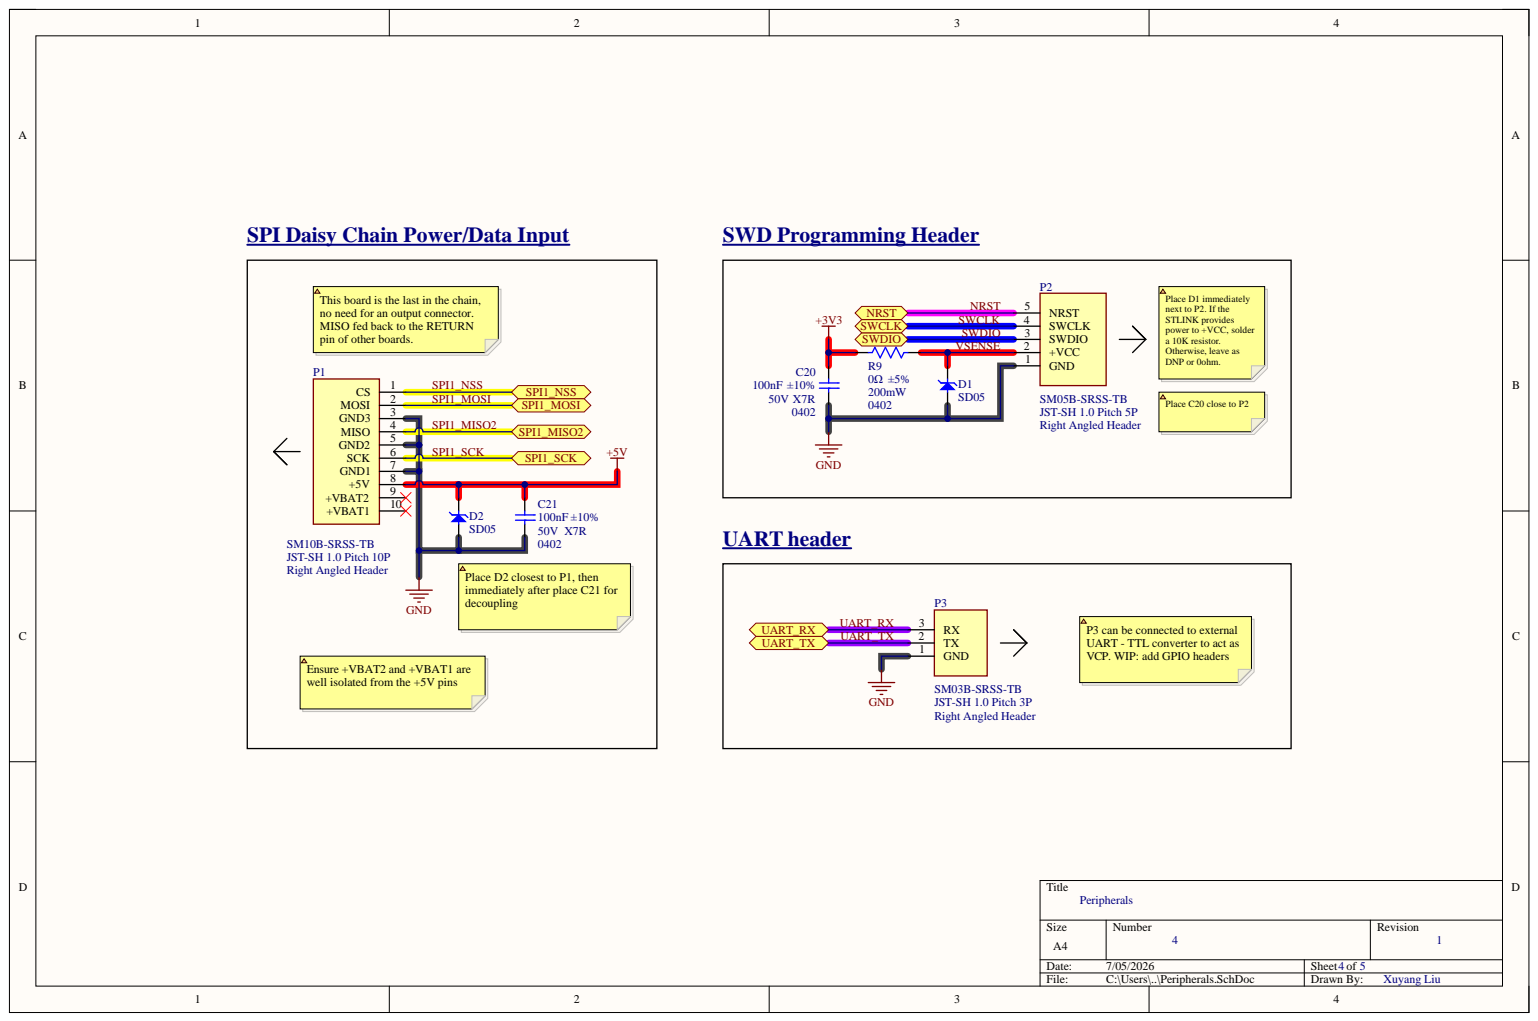
[picture p22: page 4]

This board is the last in the chain,
no need for an output connector.
MISO fed back to the RETURN
pin of other boards.

Place D1 immediately
next to P2. If the
STLINK provides
power to +VCC, solder
a 10K resistor.
Otherwise, leave as
DNP or 0ohm.

Place D2 closest to P1, then
immediately after place C21 for
decoupling

P3 can be connected to external
UART - TTL converter to act as
VCP. WIP: add GPIO headers

Ensure +VBAT2 and +VBAT1 are
well isolated from the +5V pins

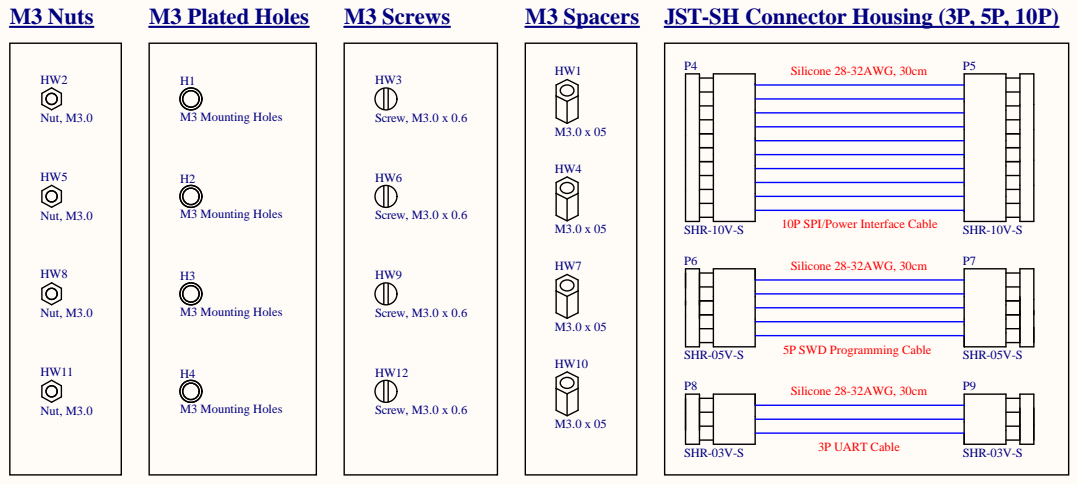
[picture p23: page 5]

10P SPI/Power Interface Cable

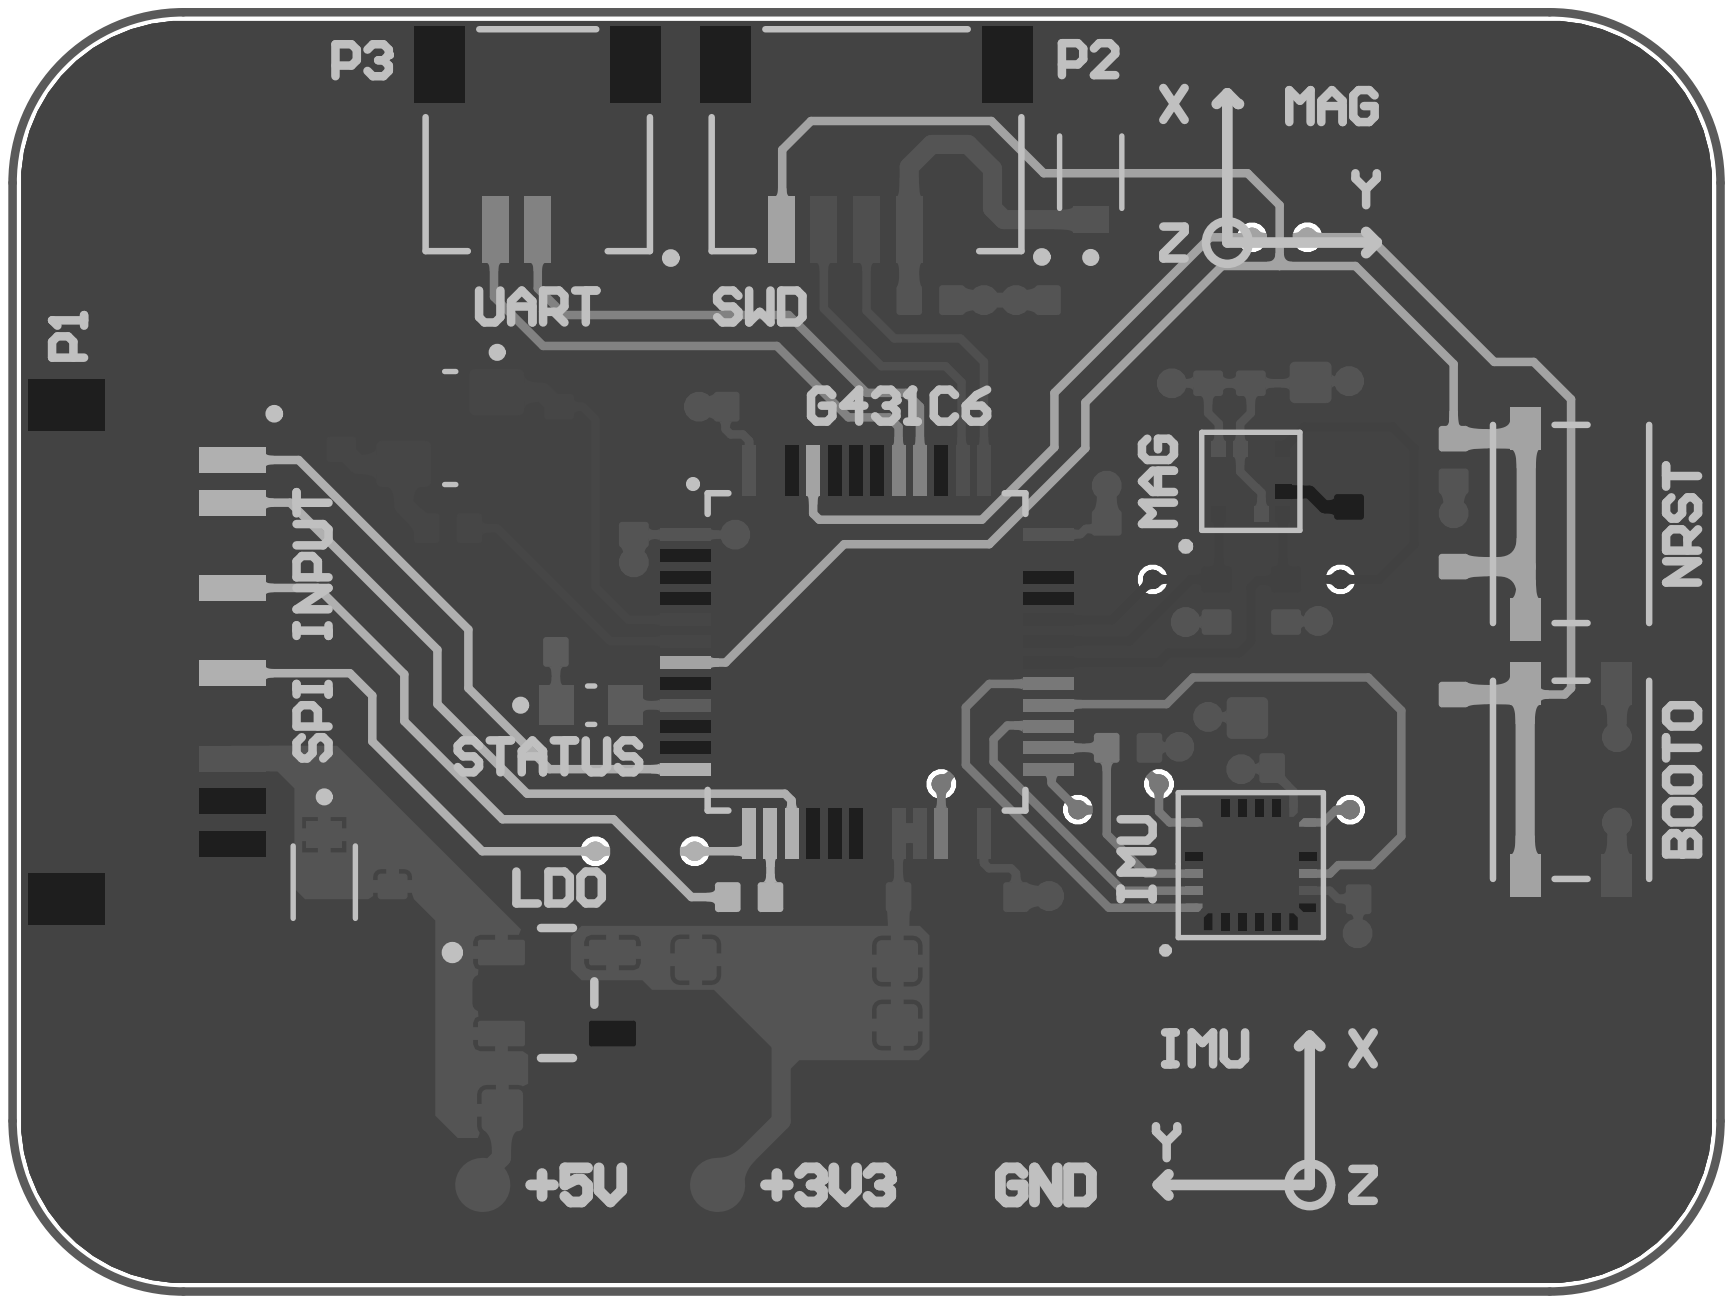
[picture p24: page 6]
