Polati1/new-tracker-hardware/NewTrackerLED/NewTrackerLED.pdf

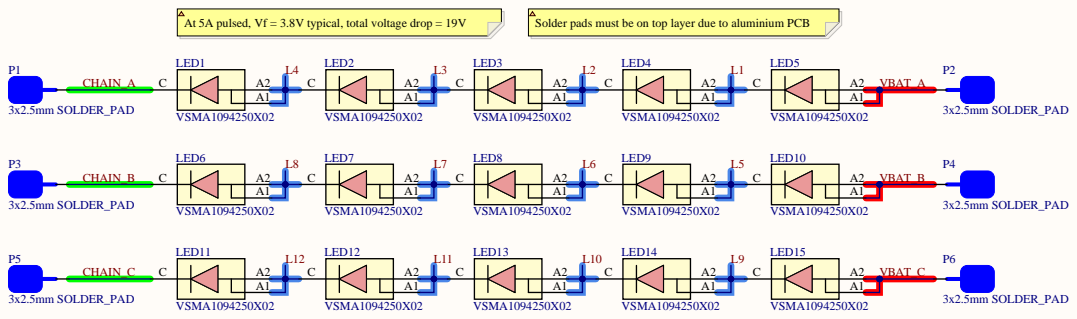
[picture p25: page 1]

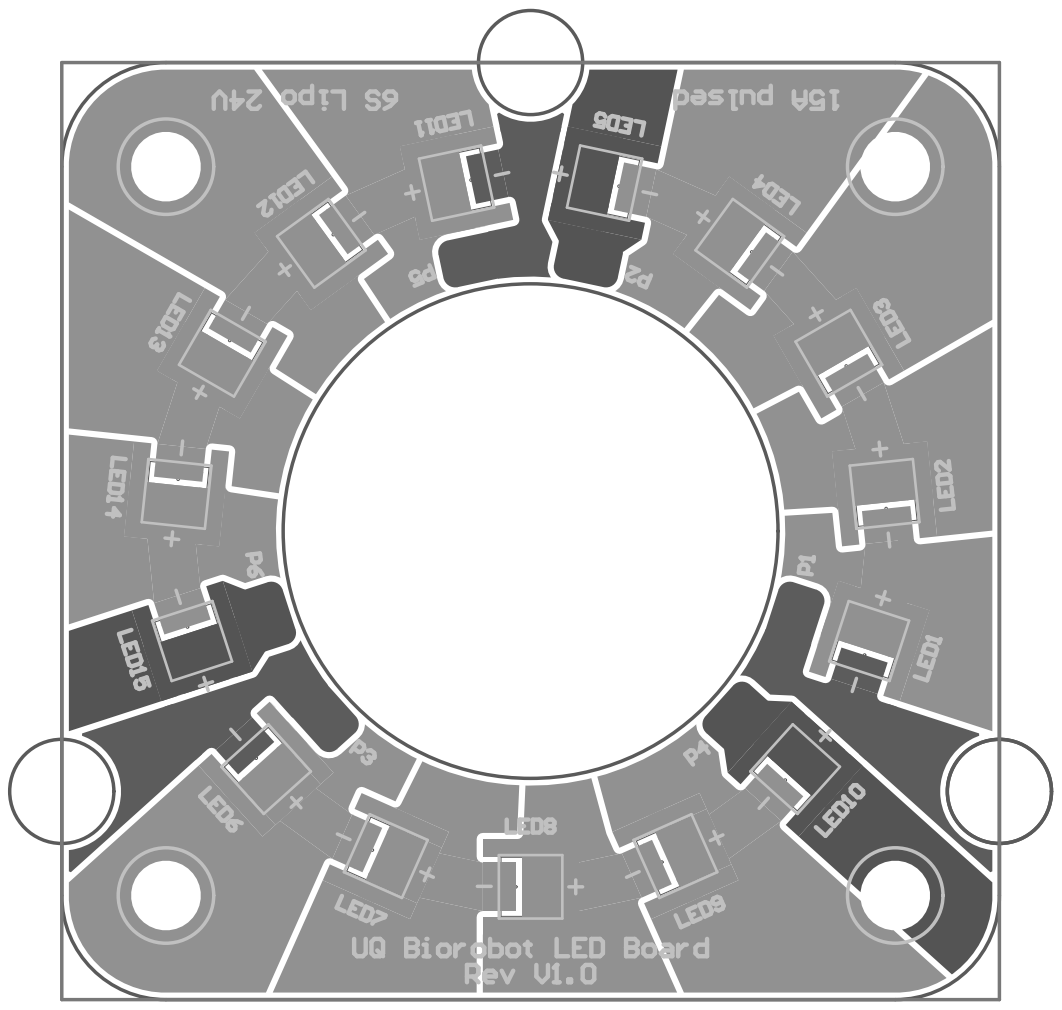
[picture p26: page 2]
