Polati1/new-tracker-hardware/(list of files, drawings)

Other design files:
NewTrackerIR/NewTrackerIR.PrjPcb
NewTrackerIR/NewTrackerIRControl.PcbDoc
NewTrackerIR/NTIR_Capacitors.SchLib
NewTrackerIR/NTIR_Connectors.PcbLib
NewTrackerIR/NTIR_Connectors.SchLib
NewTrackerIR/NTIR_Integrated_IC.PcbLib
NewTrackerIR/NTIR_Integrated_IC.SchLib
NewTrackerIR/NTIR_Mechanical.SchLib
NewTrackerIR/NTIR_Miscellaneous.PcbLib
NewTrackerIR/NTIR_Miscellaneous.SchLib
NewTrackerIR/NTIR_Other_Passives.SchLib
NewTrackerIR/NTIR_Passives.PcbLib
NewTrackerIR/NTIR_Resistors.SchLib
NewTrackerIR/Sheet1.SchDoc
NewTrackerLED/NewTrackerIRLED.PcbDoc
NewTrackerLED/NewTrackerLED.PrjPcb
NewTrackerLED/Sheet2.SchDoc
NewTrackerMain/MCU.SchDoc
NewTrackerMain/Motor1.SchDoc
NewTrackerMain/Motor2.SchDoc
NewTrackerMain/NewTrackerMain.PrjPcb
NewTrackerMain/NTM_Capacitors.SchLib
NewTrackerMain/NTM_Connectors.PcbLib
NewTrackerMain/NTM_Connectors.SchLib
NewTrackerMain/NTM_Integrated_IC.PcbLib
NewTrackerMain/NTM_Integrated_IC.SchLib
NewTrackerMain/NTM_Mechanical.PcbLib
NewTrackerMain/NTM_Mechanical.SchLib
NewTrackerMain/NTM_Miscellaneous.PcbLib
NewTrackerMain/NTM_Miscellaneous.SchLib
NewTrackerMain/NTM_Other_Passives.SchLib
NewTrackerMain/NTM_Passives.PcbLib
NewTrackerMain/NTM_Resistors.SchLib
NewTrackerMain/Overview.SchDoc
NewTrackerMain/PCB1.PcbDoc
NewTrackerMain/PCB2.PcbDoc
NewTrackerMain/Peripherals.SchDoc
NewTrackerMain/StepperPower.SchDoc
NewTrackerMotor/Driver.SchDoc
NewTrackerMotor/Encoder.SchDoc
NewTrackerMotor/MCU_Core.SchDoc
NewTrackerMotor/Mechanical.SchDoc
NewTrackerMotor/NewTracker.PrjPcb
NewTrackerMotor/NewTrackerBoard.PcbDoc
NewTrackerMotor/NT_Capacitors.SchLib
NewTrackerMotor/NT_Connectors.PcbLib
NewTrackerMotor/NT_Connectors.SchLib
NewTrackerMotor/NT_Integrated_IC.PcbLib
NewTrackerMotor/NT_Integrated_IC.SchLib
NewTrackerMotor/NT_Mechanical.PcbLib
NewTrackerMotor/NT_Mechanical.SchLib
NewTrackerMotor/NT_Miscellaneous.PcbLib
NewTrackerMotor/NT_Miscellaneous.SchLib
NewTrackerMotor/NT_Other_Passives.SchLib
NewTrackerMotor/NT_Passives.PcbLib
NewTrackerMotor/NT_Resistors.SchLib
NewTrackerMotor/Overview.SchDoc
NewTrackerMotor/Peripherals.SchDoc
NewTrackerMotor/Power.SchDoc
NewTrackerSense/MCU.SchDoc
NewTrackerSense/Mechanical.SchDoc
NewTrackerSense/NewTrackerSense.PrjPcb
NewTrackerSense/NewTrackerSenseBoard.PcbDoc
NewTrackerSense/NTS_Capacitors.SchLib
NewTrackerSense/NTS_Connectors.PcbLib
NewTrackerSense/NTS_Connectors.SchLib
NewTrackerSense/NTS_Integrated_IC.PcbLib
NewTrackerSense/NTS_Integrated_IC.SchLib
NewTrackerSense/NTS_Mechanical.PcbLib
NewTrackerSense/NTS_Mechanical.SchLib
NewTrackerSense/NTS_Miscellaneous.PcbLib
NewTrackerSense/NTS_Miscellaneous.SchLib
NewTrackerSense/NTS_Other_Passives.SchLib
NewTrackerSense/NTS_Passives.PcbLib
NewTrackerSense/NTS_Resistors.SchLib
NewTrackerSense/Overview.SchDoc
NewTrackerSense/Peripherals.SchDoc
NewTrackerSense/Sensors.SchDoc
Unused Documents/MT6835 Board/MT6835 Board.PrjPcb
Unused Documents/MT6835 Board/Sensor.PcbDoc
Unused Documents/MT6835 Board/Sensor.PcbLib
Unused Documents/MT6835 Board/Sensor.SchDoc
Unused Documents/MT6835 Board/Sensor.SchLib
Unused Documents/PCB1.PcbDoc
Unused Documents/Peripherals.SchDoc
Unused Documents/StepperPower.SchDoc
Unused Documents/USBPower.SchDoc
